iafilius/CarElectricalRadiatorFanController/pictures/IMG_4896.JPG

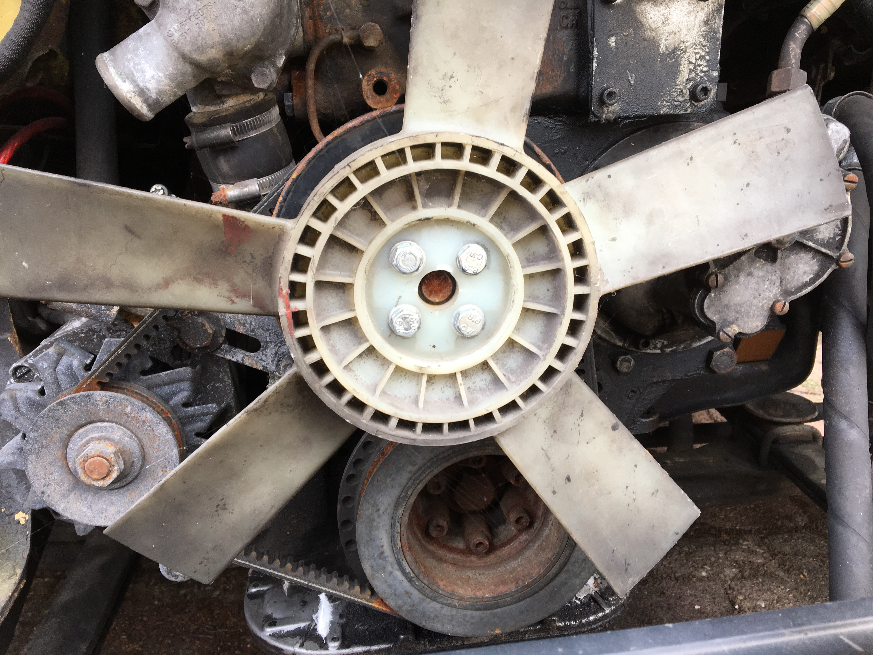
pictures/IMG_4896.JPG
