iafilius/CarElectricalRadiatorFanController/pictures/IMG_5004.JPG

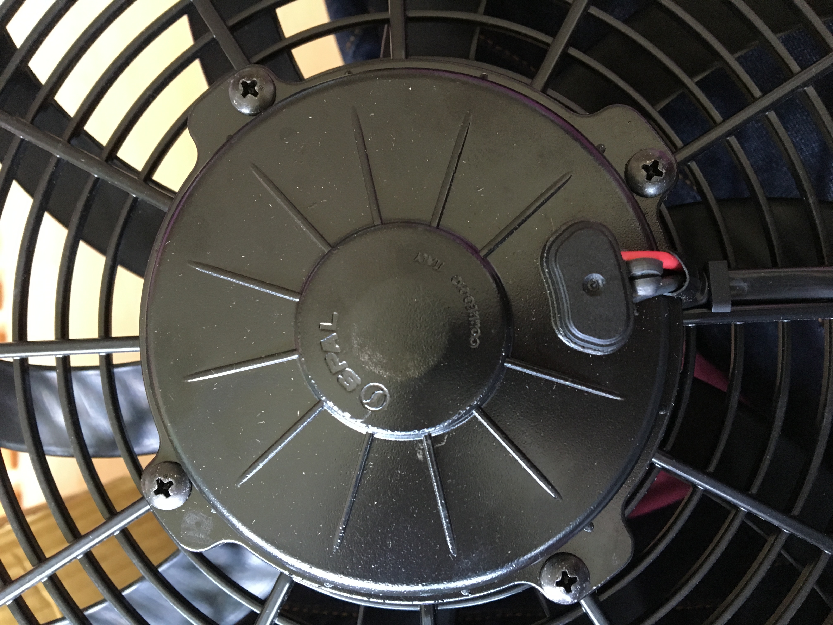
pictures/IMG_5004.JPG
