iafilius/CarElectricalRadiatorFanController/pictures/IMG_5005.JPG

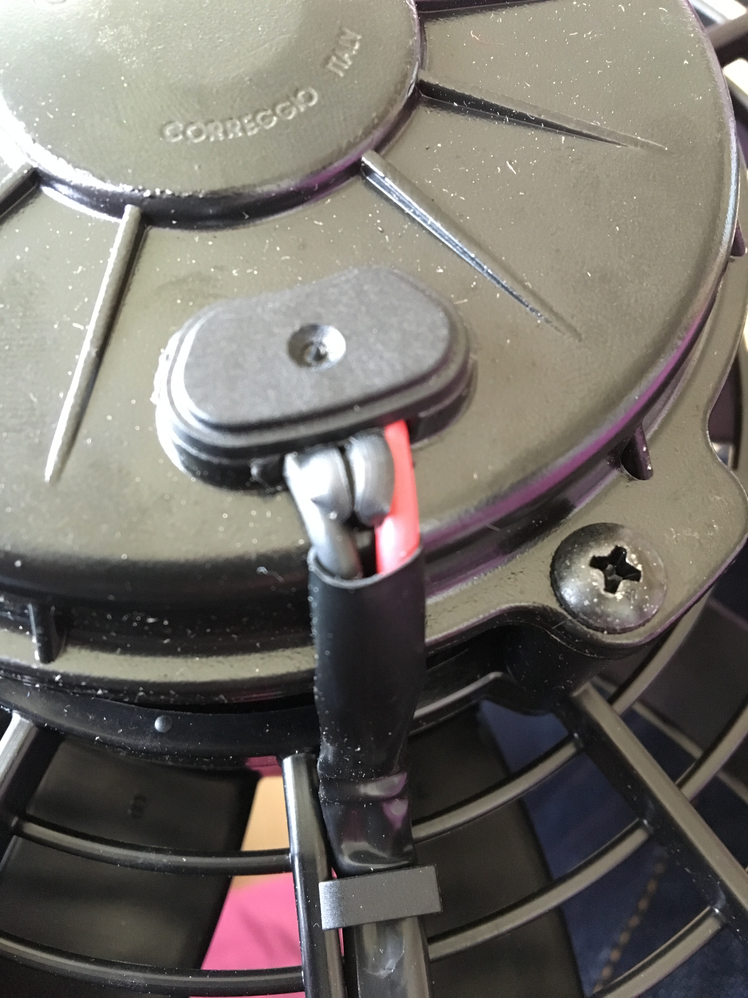
pictures/IMG_5005.JPG
