iafilius/CarElectricalRadiatorFanController/pictures/IMG_5008.JPG

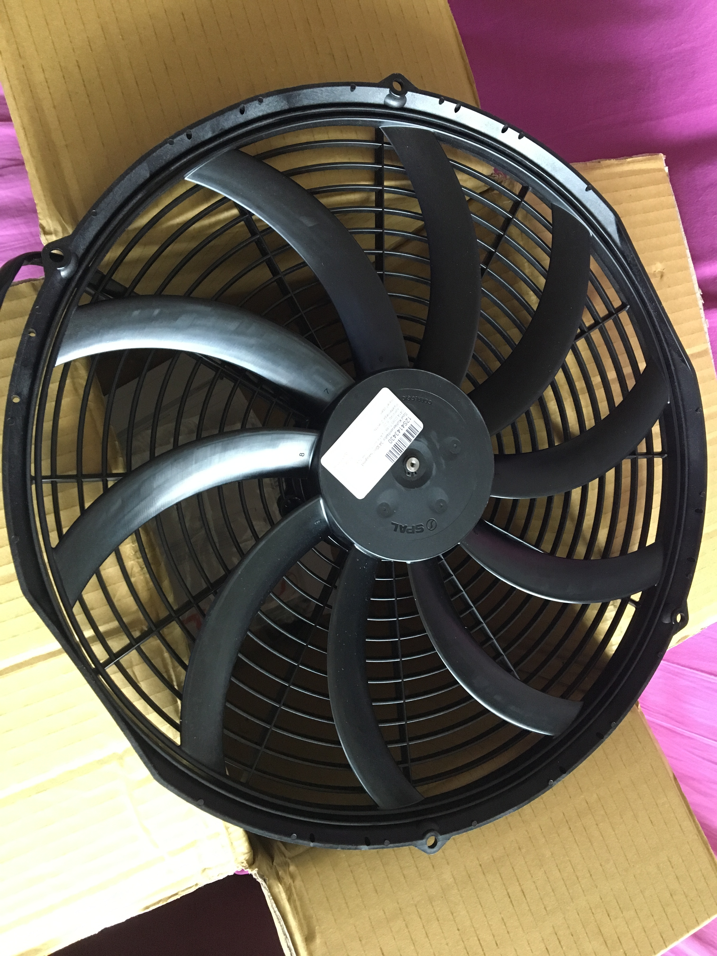
pictures/IMG_5008.JPG
