iafilius/CarElectricalRadiatorFanController/pictures/IMG_5502.JPG

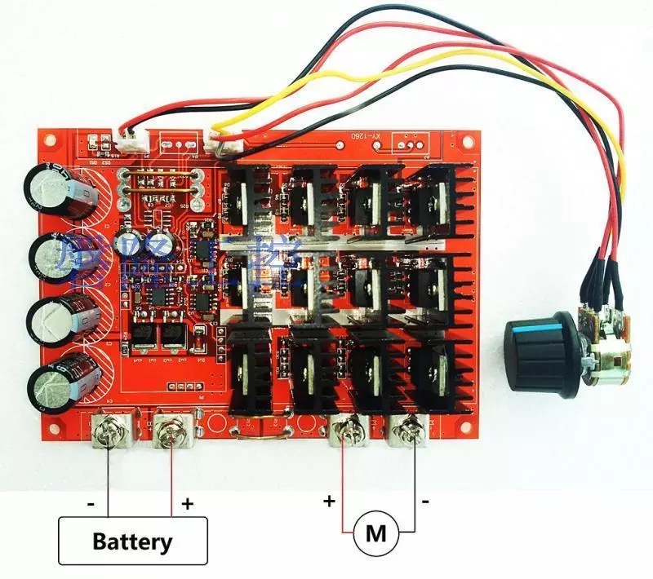
pictures/IMG_5502.JPG
