iafilius/CarElectricalRadiatorFanController/pictures/IMG_5505 - Copy.JPG

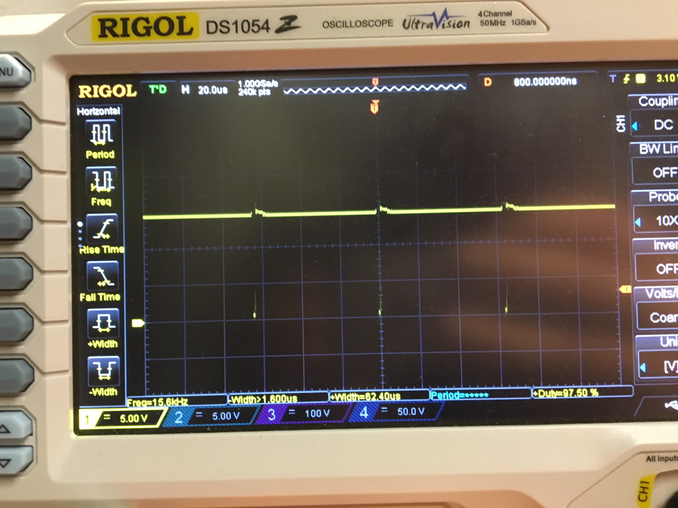
pictures/IMG_5505 - Copy.JPG
