iafilius/CarElectricalRadiatorFanController/pictures/IMG_5506 - Copy.JPG

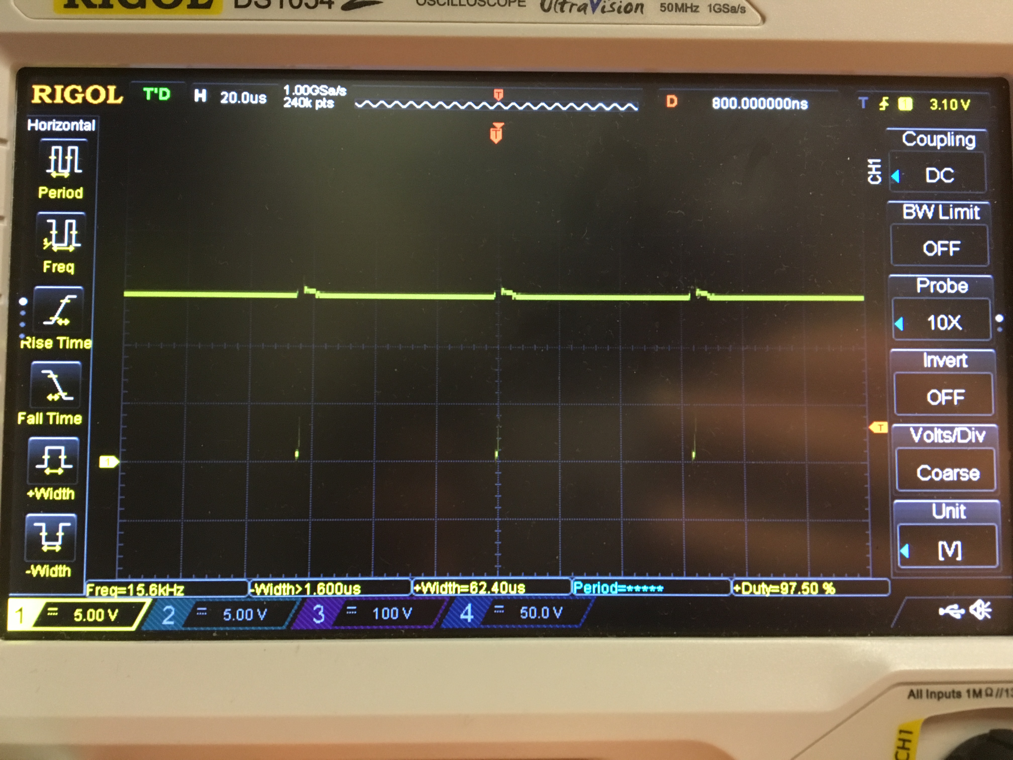
pictures/IMG_5506 - Copy.JPG
