iafilius/CarElectricalRadiatorFanController/pictures/IMG_5507 - Copy.JPG

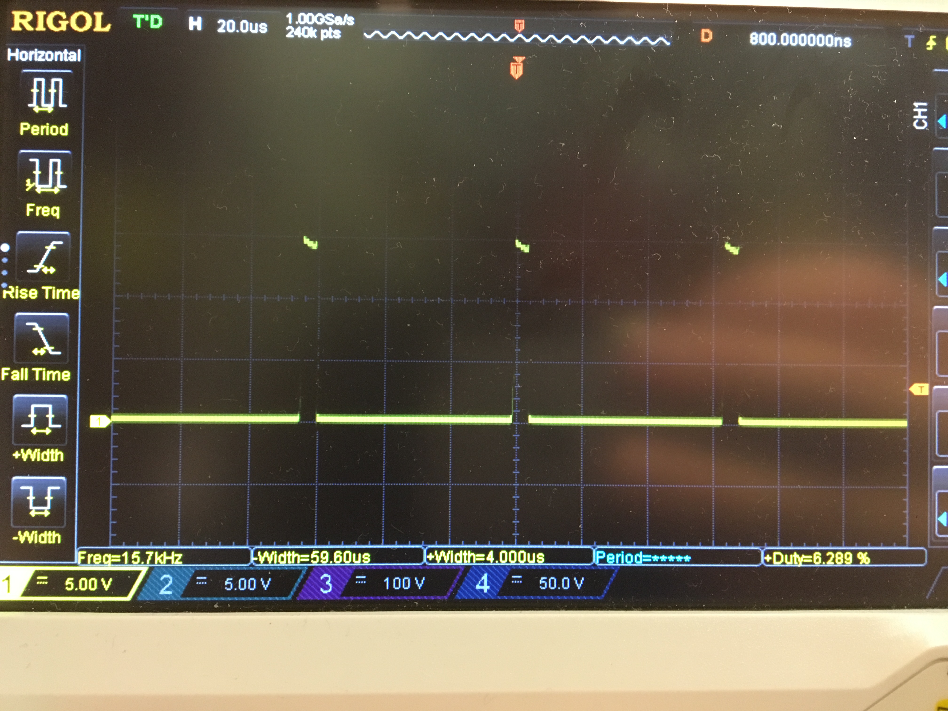
pictures/IMG_5507 - Copy.JPG
