iafilius/CarElectricalRadiatorFanController/pictures/IMG_5509 - Copy.JPG

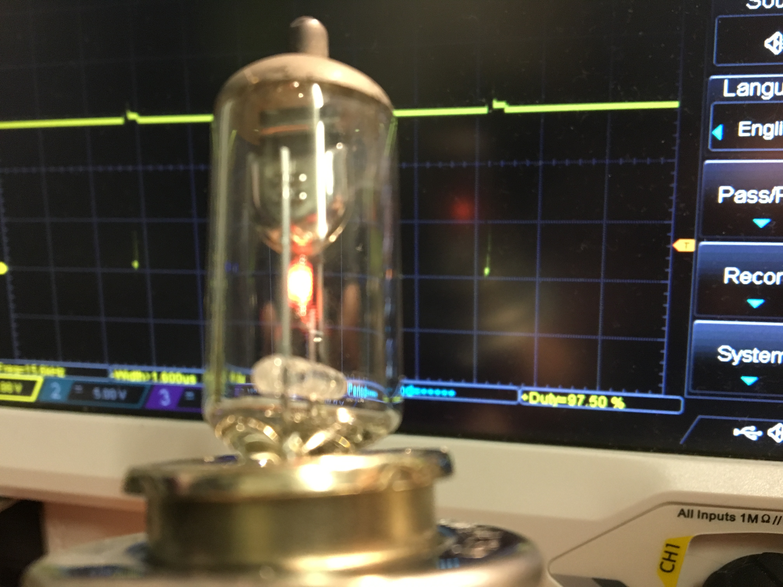
pictures/IMG_5509 - Copy.JPG
