iafilius/CarElectricalRadiatorFanController/pictures/IMG_5516.JPG

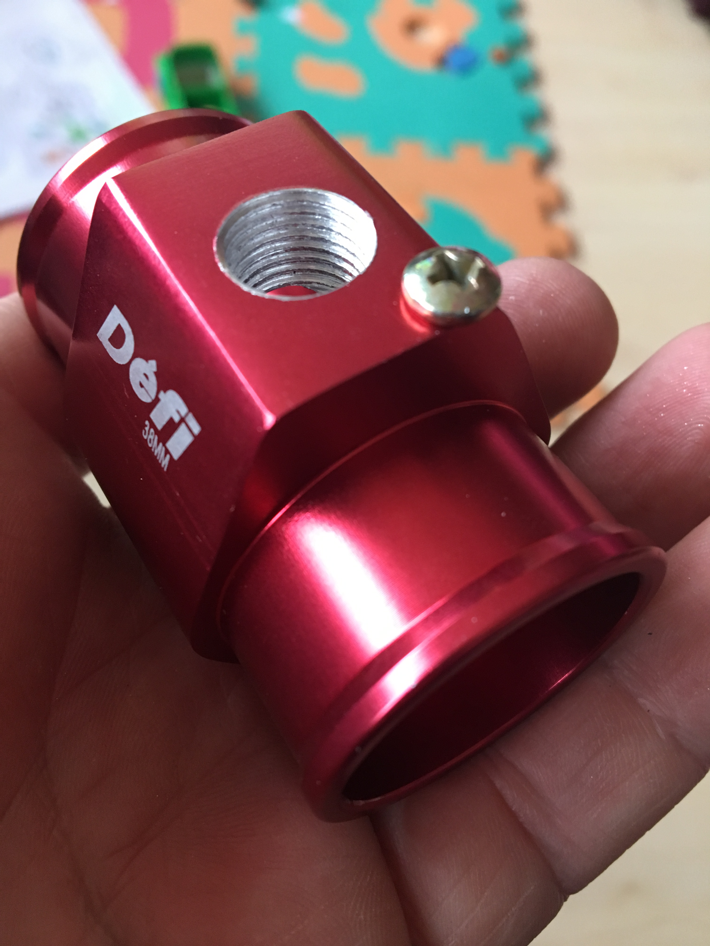
pictures/IMG_5516.JPG
