iafilius/CarElectricalRadiatorFanController/pictures/IMG_5518.JPG

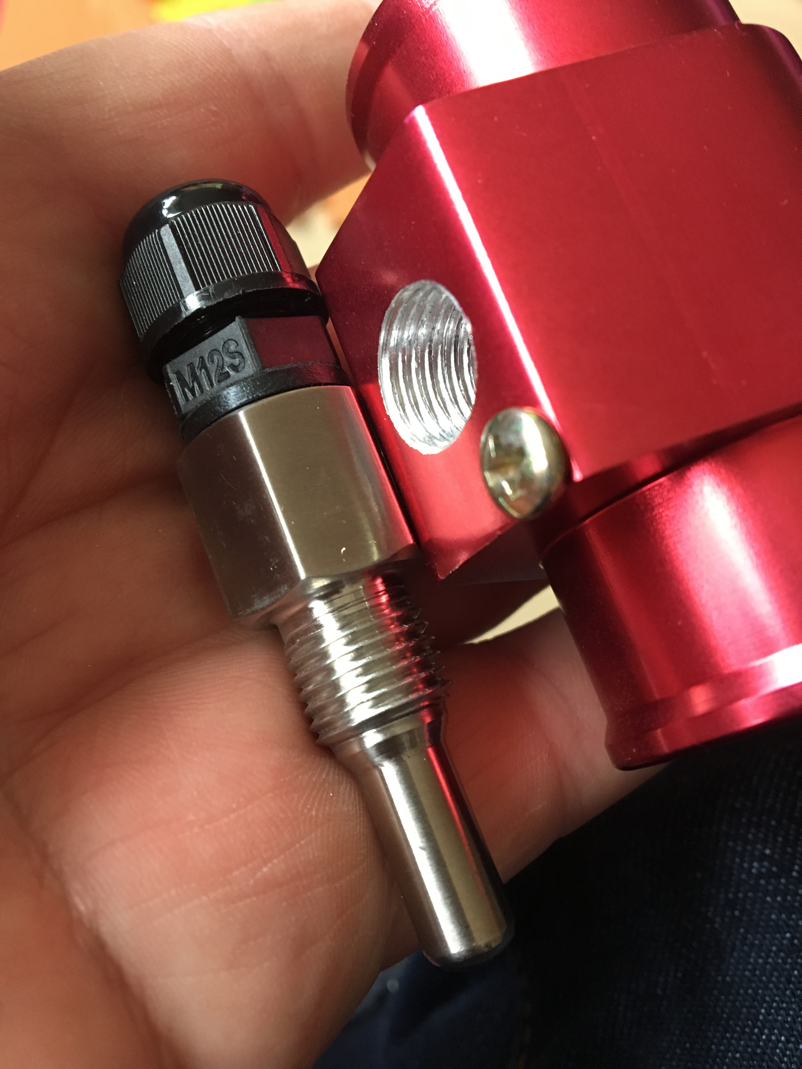
pictures/IMG_5518.JPG
