iafilius/CarElectricalRadiatorFanController/pictures/IMG_5519.JPG

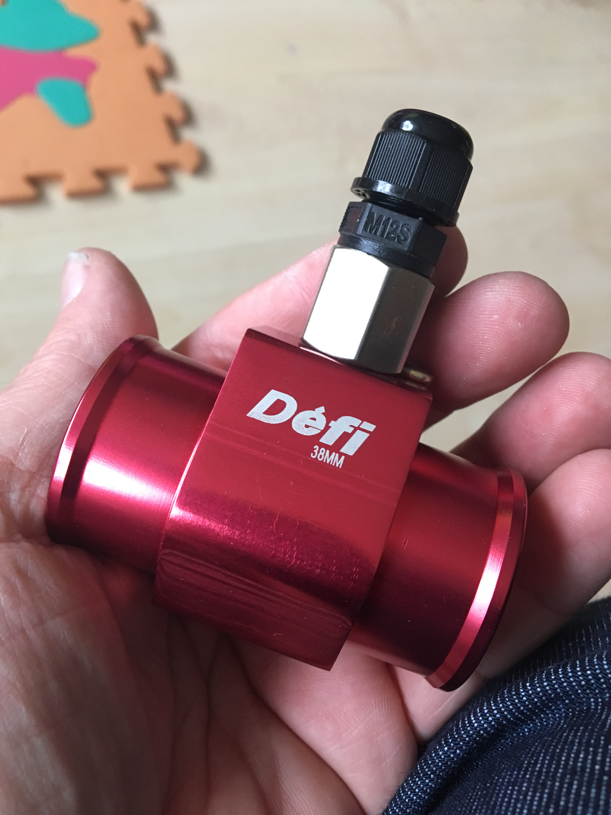
pictures/IMG_5519.JPG
