iafilius/CarElectricalRadiatorFanController/pictures/IMG_5520.JPG

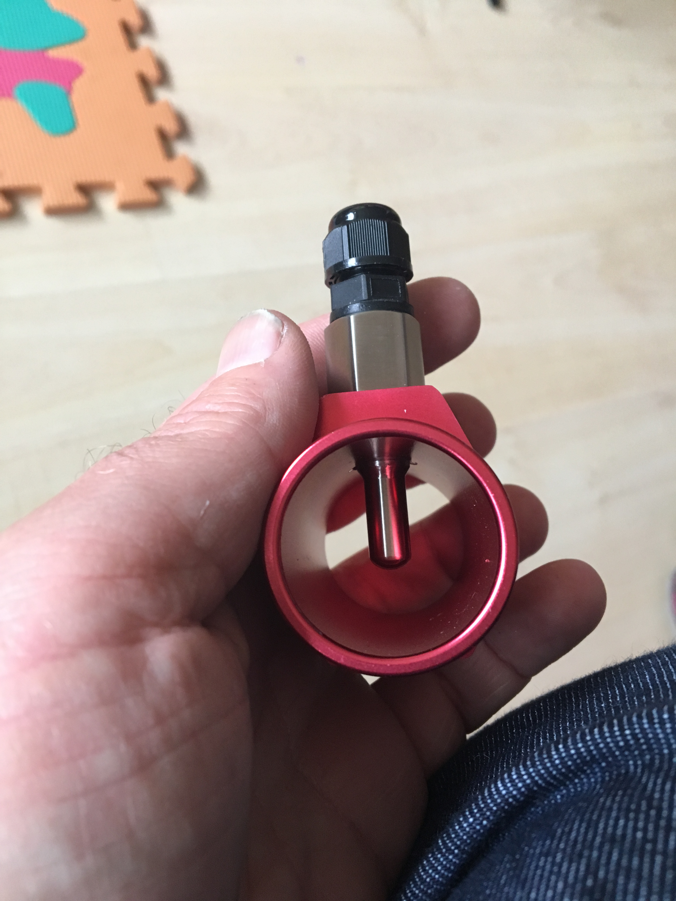
pictures/IMG_5520.JPG
