iafilius/CarElectricalRadiatorFanController/pictures/IMG_5521.JPG

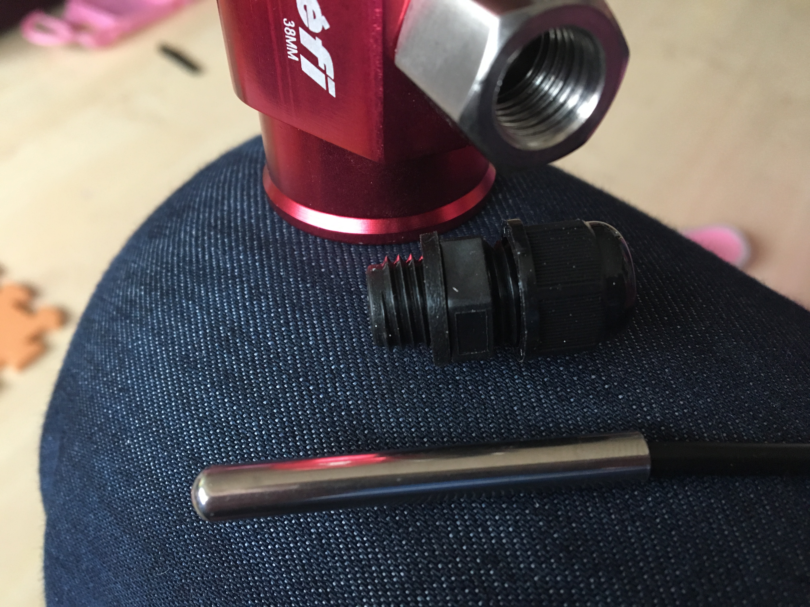
pictures/IMG_5521.JPG
