iafilius/CarElectricalRadiatorFanController/pictures/IMG_5522.JPG

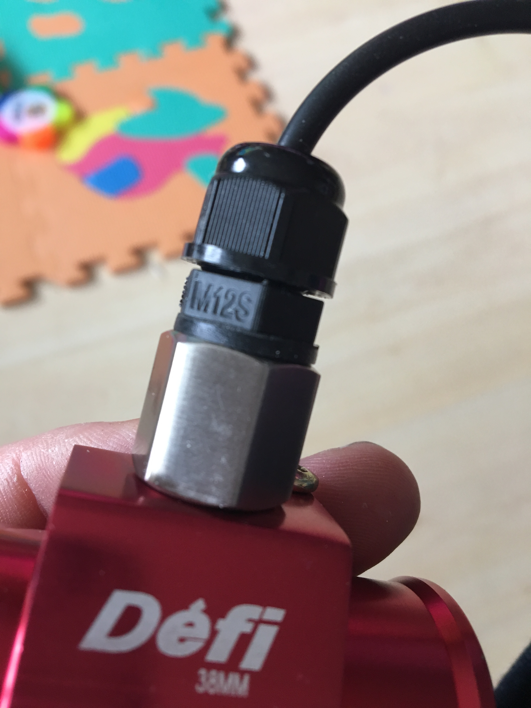
pictures/IMG_5522.JPG
