iafilius/CarElectricalRadiatorFanController/pictures/IMG_5523.JPG

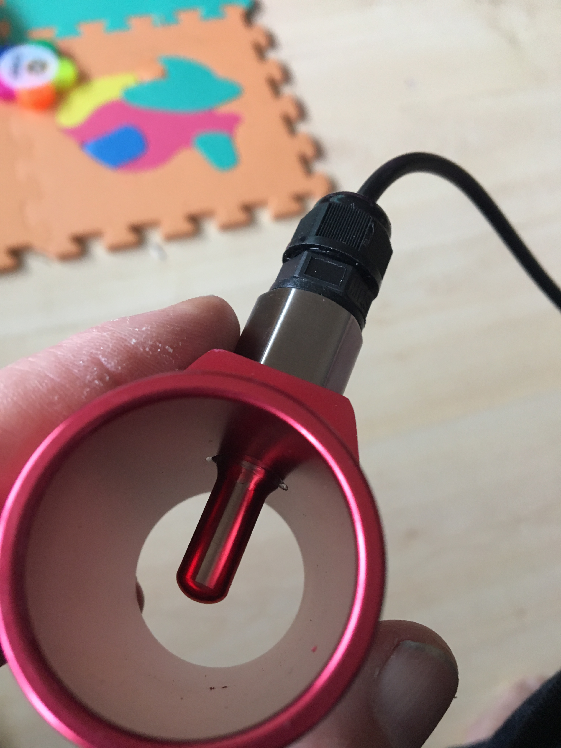
pictures/IMG_5523.JPG
