iafilius/CarElectricalRadiatorFanController/pictures/IMG_5721.JPG

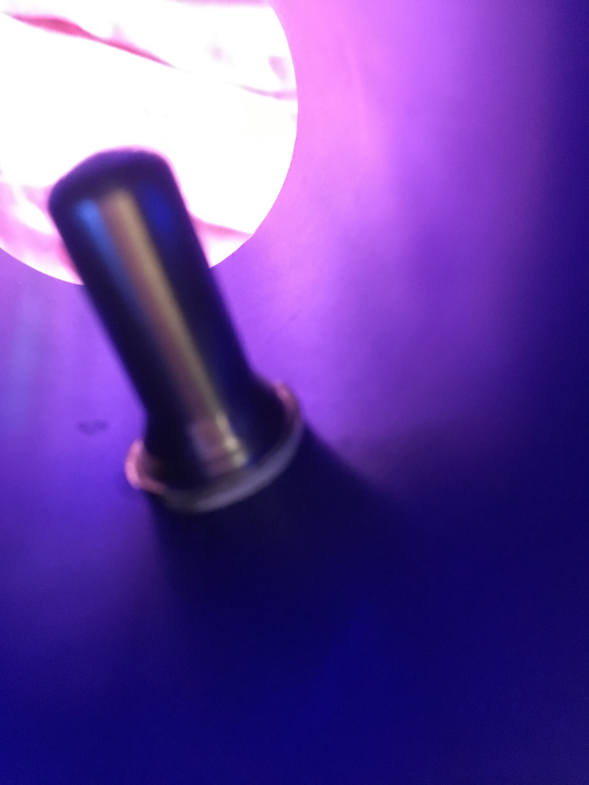
pictures/IMG_5721.JPG
