iafilius/CarElectricalRadiatorFanController/pictures/IMG_5722.JPG

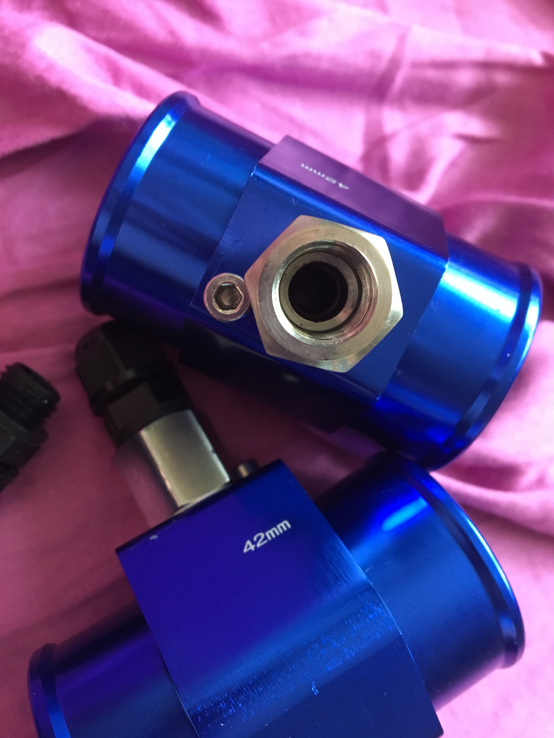
pictures/IMG_5722.JPG
