iafilius/CarElectricalRadiatorFanController/pictures/IMG_5723.JPG

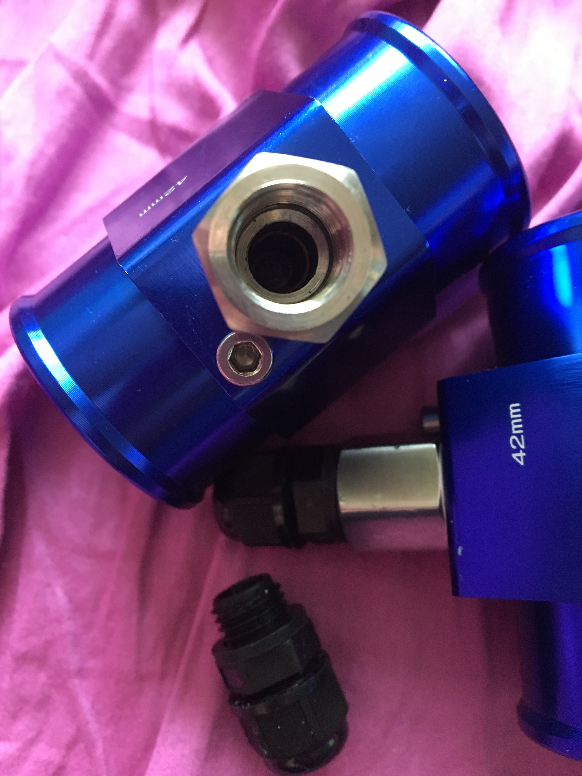
pictures/IMG_5723.JPG
