iafilius/CarElectricalRadiatorFanController/pictures/IMG_5724.JPG

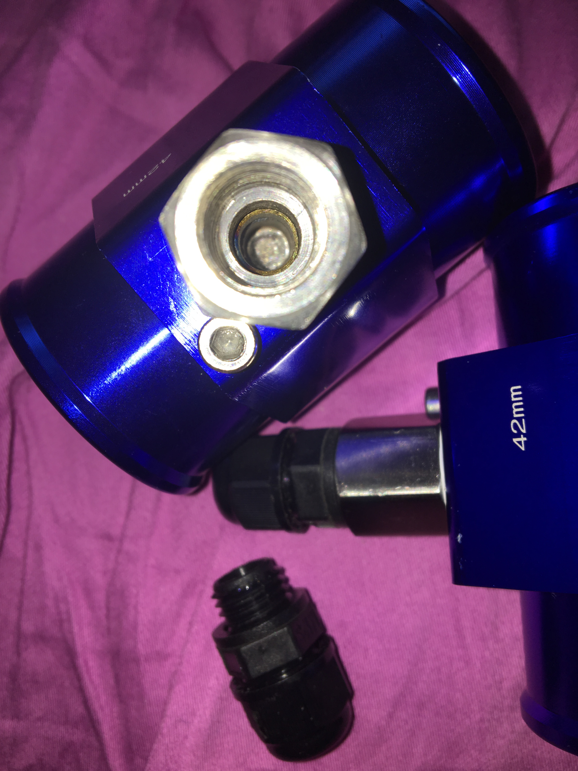
pictures/IMG_5724.JPG
