iafilius/CarElectricalRadiatorFanController/pictures/IMG_5725.JPG

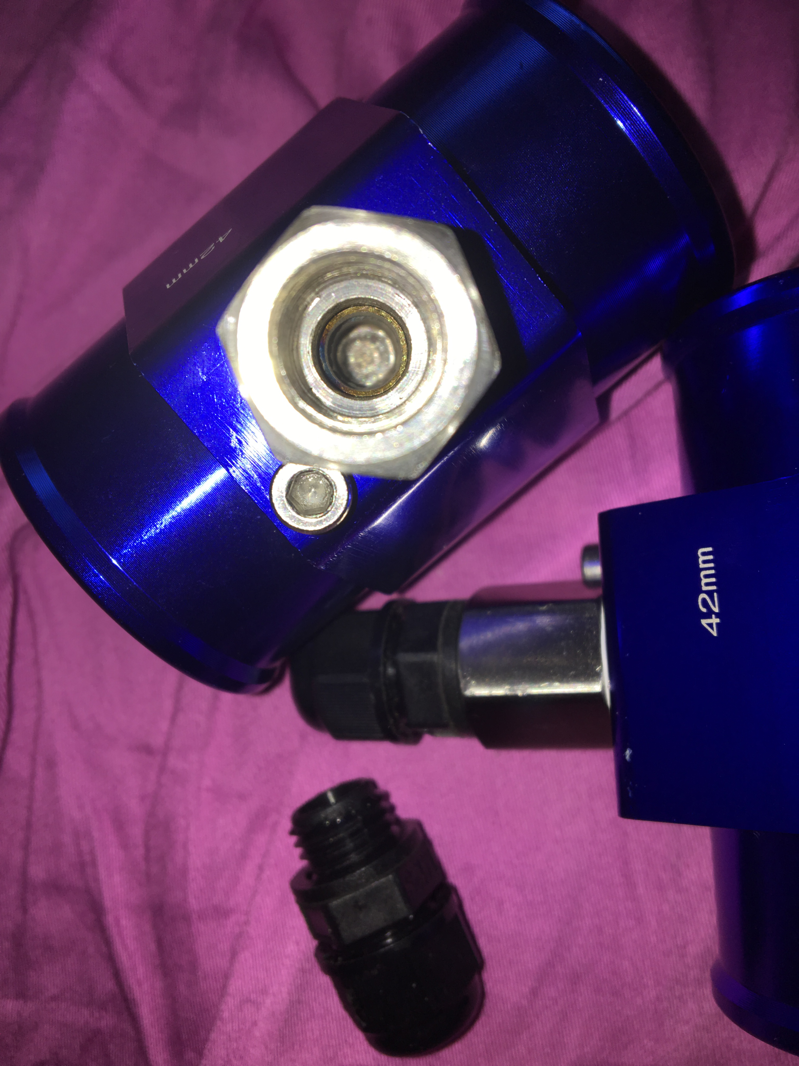
pictures/IMG_5725.JPG
