iafilius/CarElectricalRadiatorFanController/pictures/IMG_5726.JPG

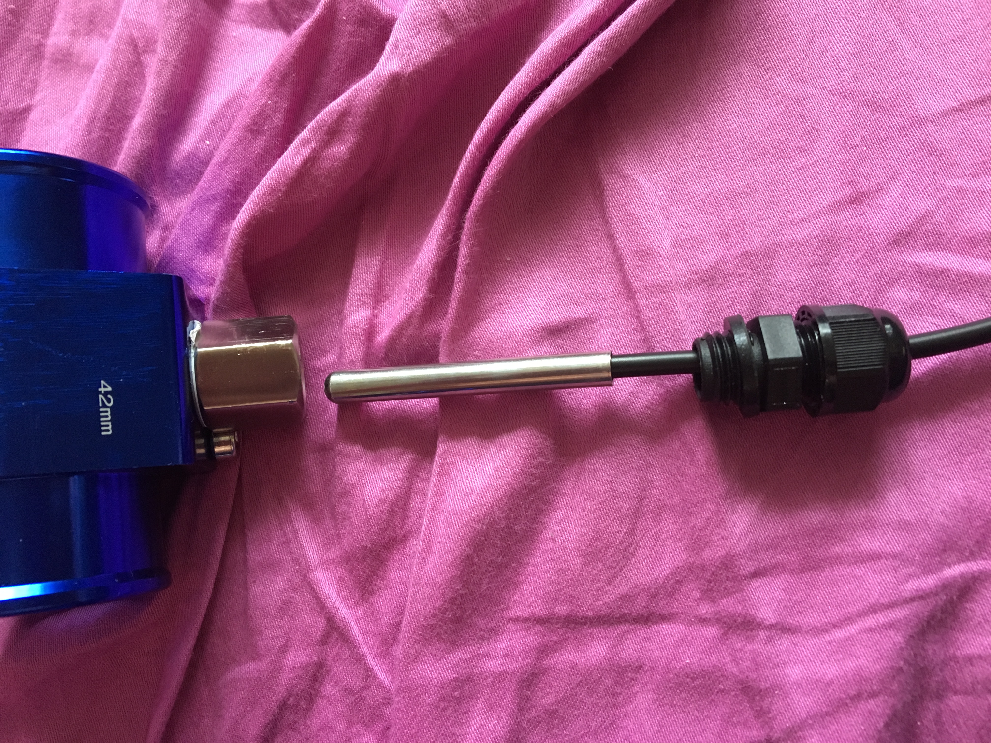
pictures/IMG_5726.JPG
