iafilius/CarElectricalRadiatorFanController/pictures/IMG_5727.JPG

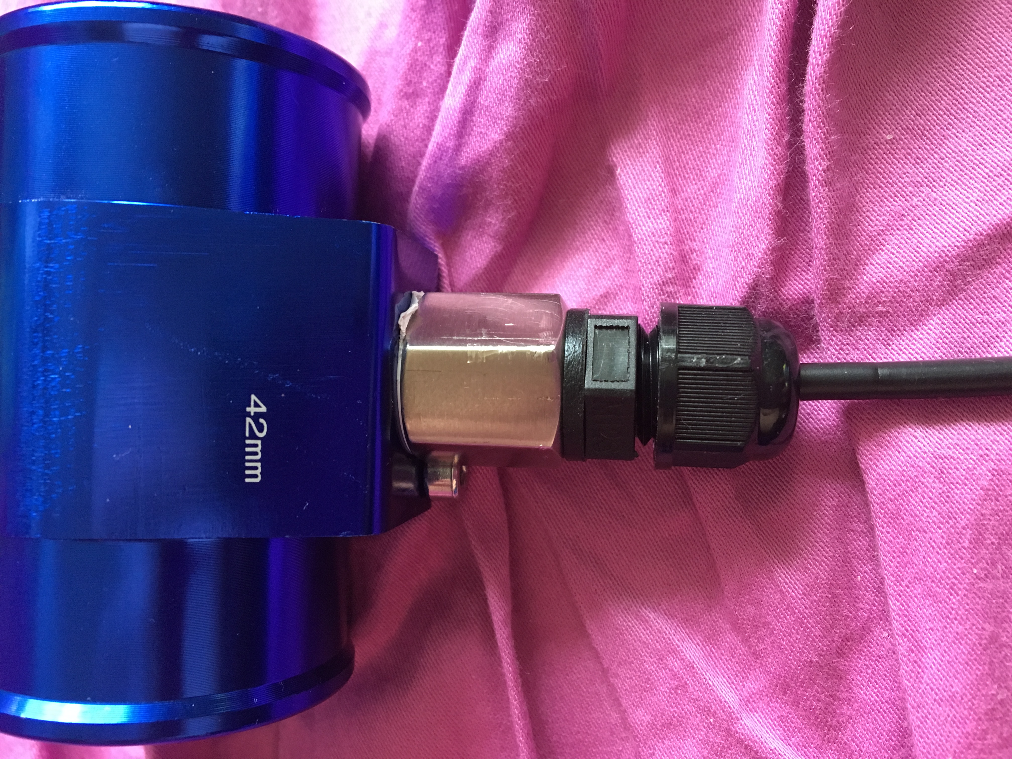
pictures/IMG_5727.JPG
