iafilius/CarElectricalRadiatorFanController/pictures/IMG_5729.JPG

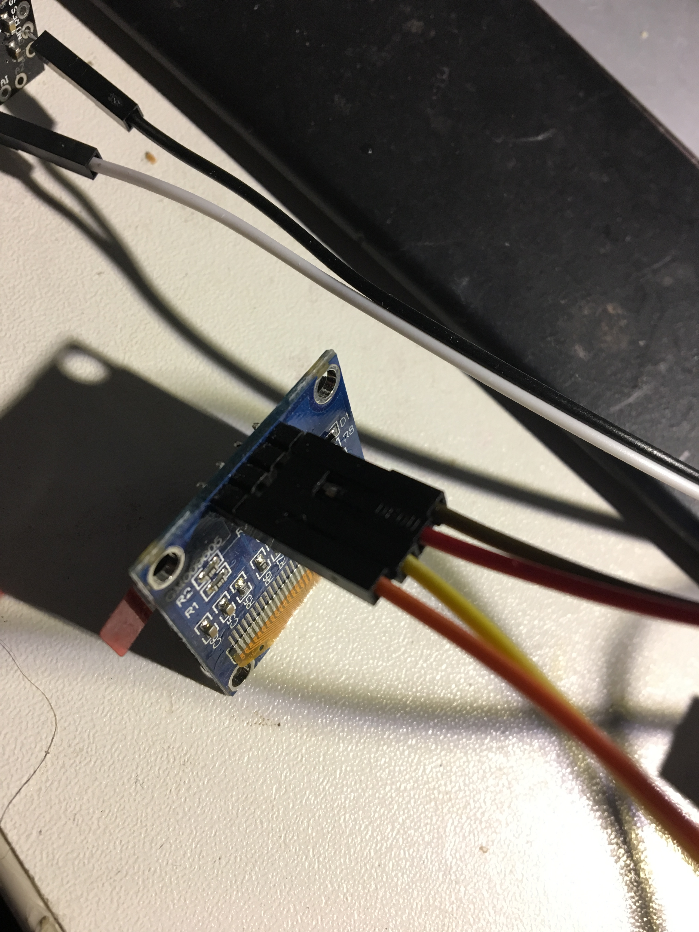
pictures/IMG_5729.JPG
