iafilius/CarElectricalRadiatorFanController/pictures/IMG_8650.JPG

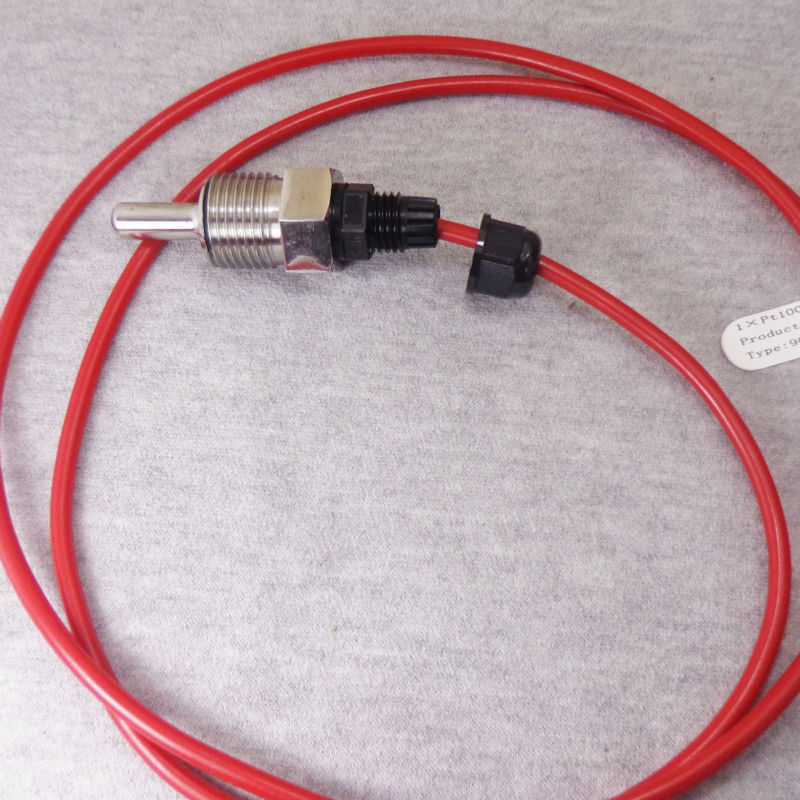
pictures/IMG_8650.JPG
