iafilius/CarElectricalRadiatorFanController/pictures/IMG_8731.JPG

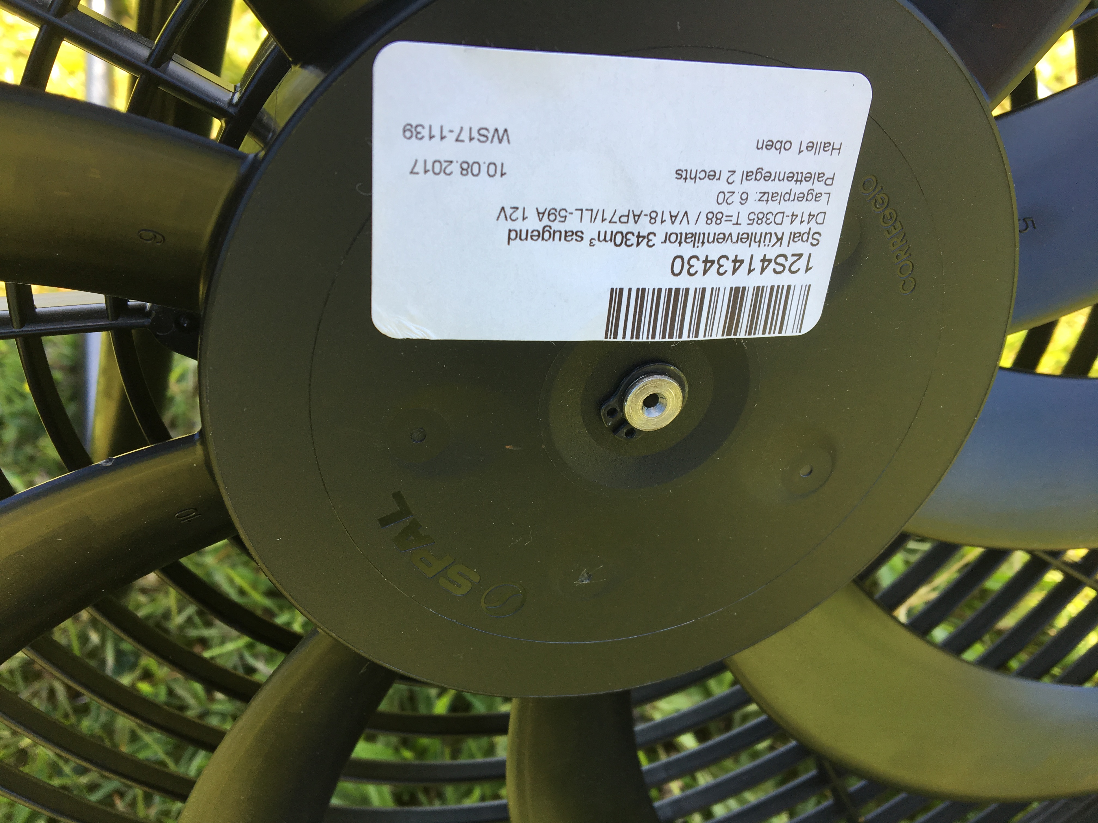
pictures/IMG_8731.JPG
