iafilius/CarElectricalRadiatorFanController/pictures/IMG_8733.JPG

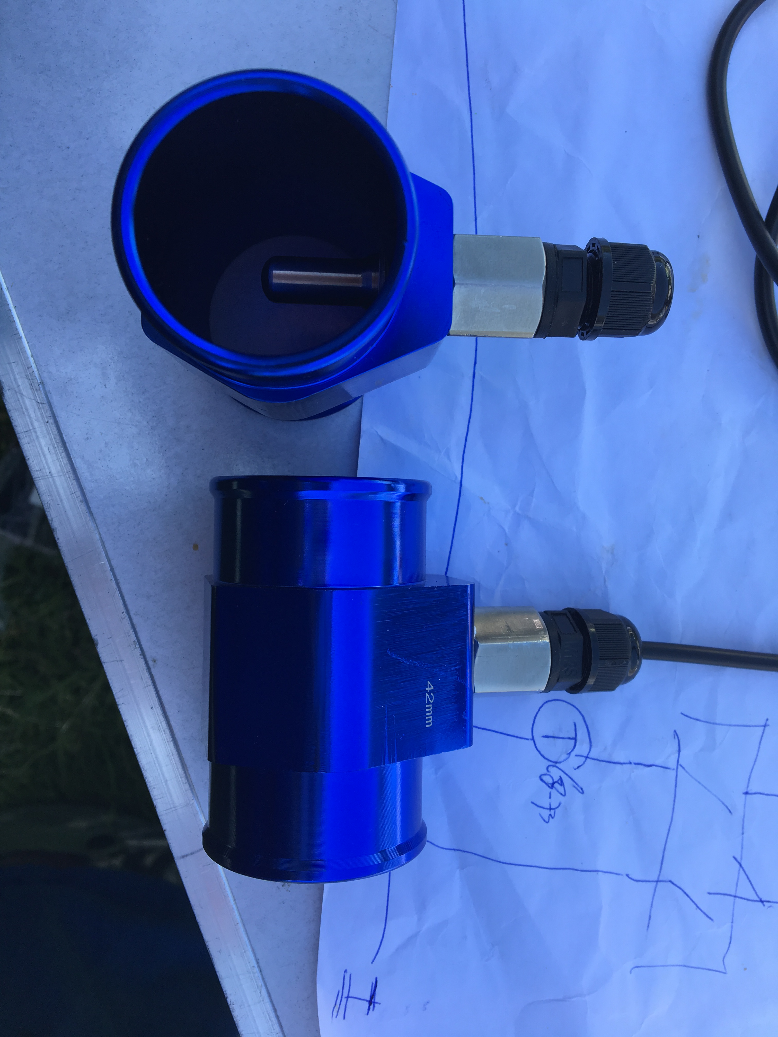
pictures/IMG_8733.JPG
