iafilius/CarElectricalRadiatorFanController/pictures/IMG_8734.JPG

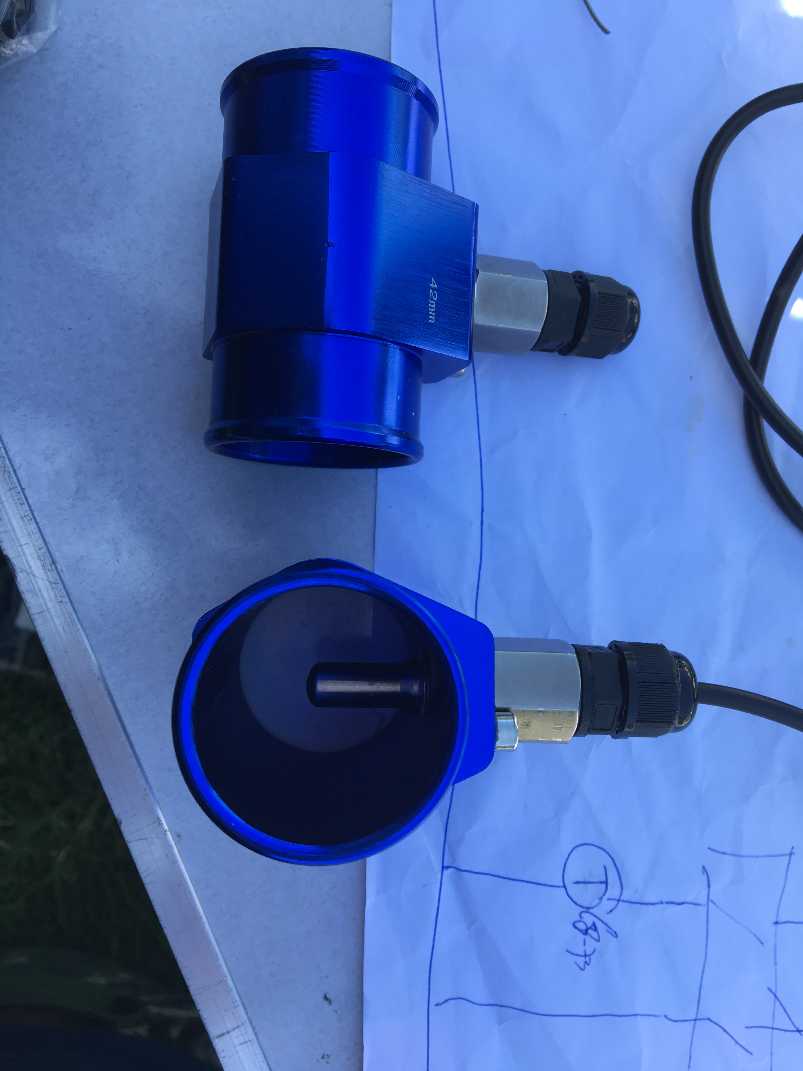
pictures/IMG_8734.JPG
