iafilius/CarElectricalRadiatorFanController/pictures/IMG_8735.JPG

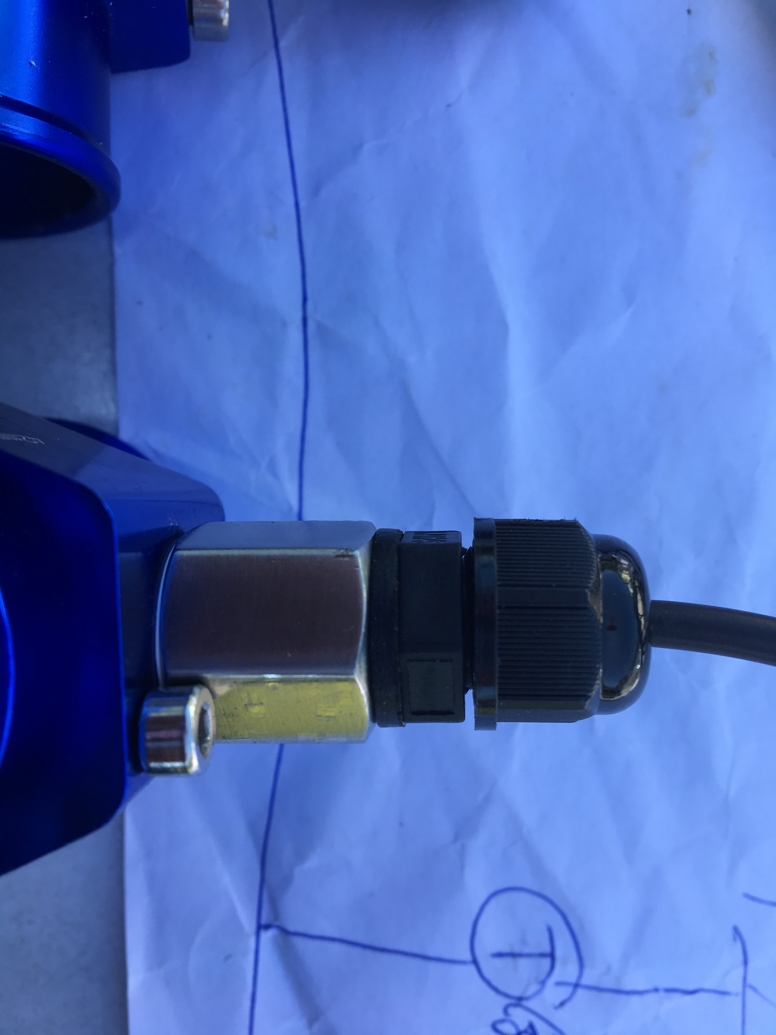
pictures/IMG_8735.JPG
