iafilius/CarElectricalRadiatorFanController/pictures/IMG_8736.JPG

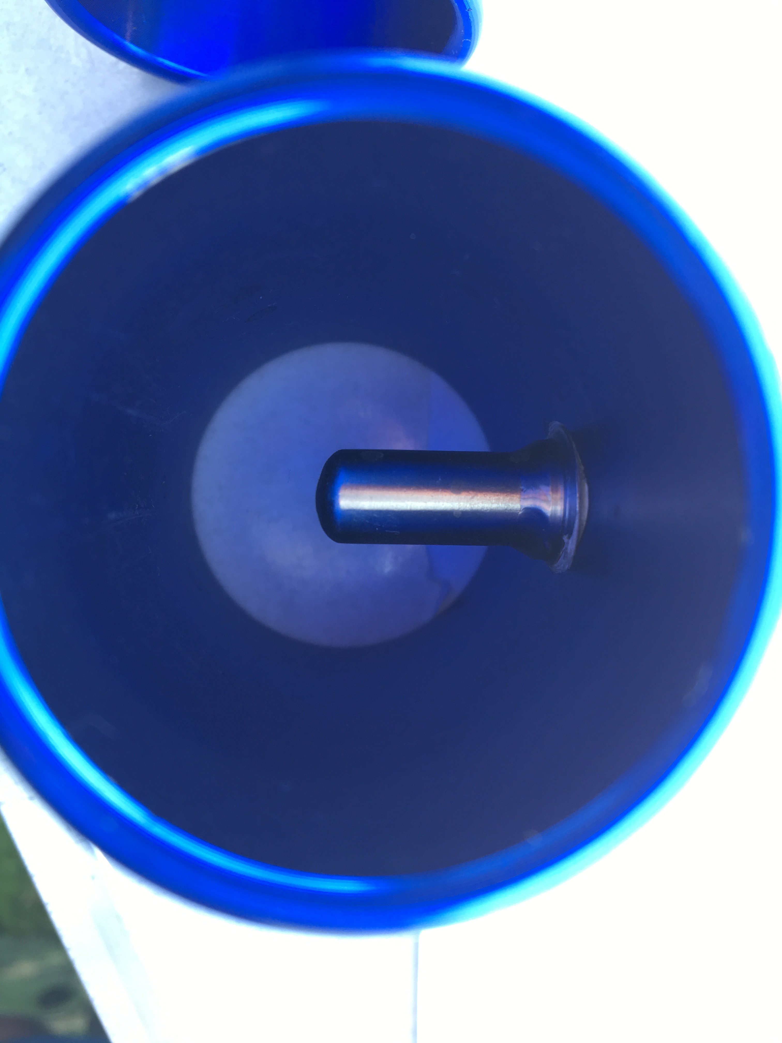
pictures/IMG_8736.JPG
