iafilius/CarElectricalRadiatorFanController/pictures/IMG_8737.JPG

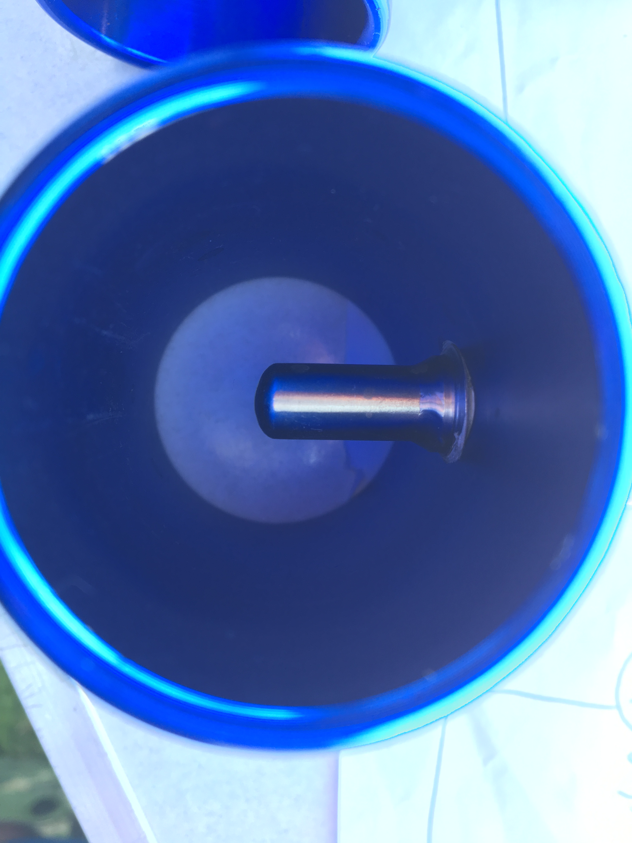
pictures/IMG_8737.JPG
