iafilius/CarElectricalRadiatorFanController/pictures/IMG_8739.JPG

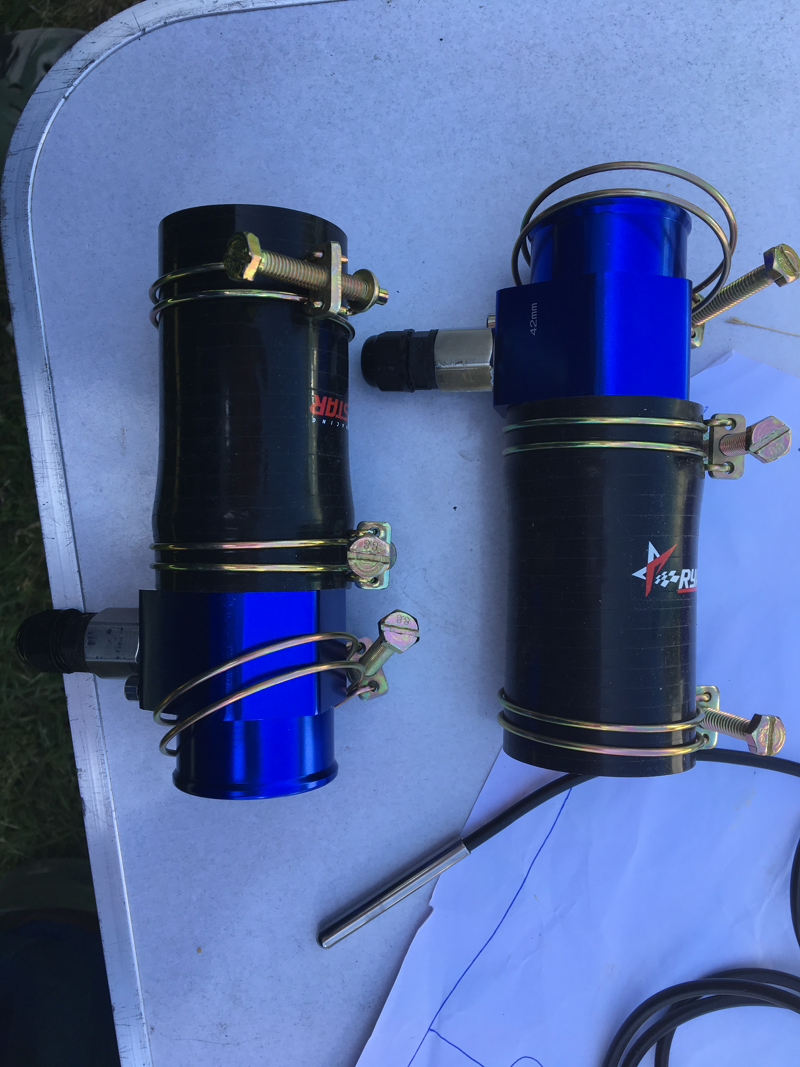
pictures/IMG_8739.JPG
