iafilius/CarElectricalRadiatorFanController/pictures/IMG_8751.JPG

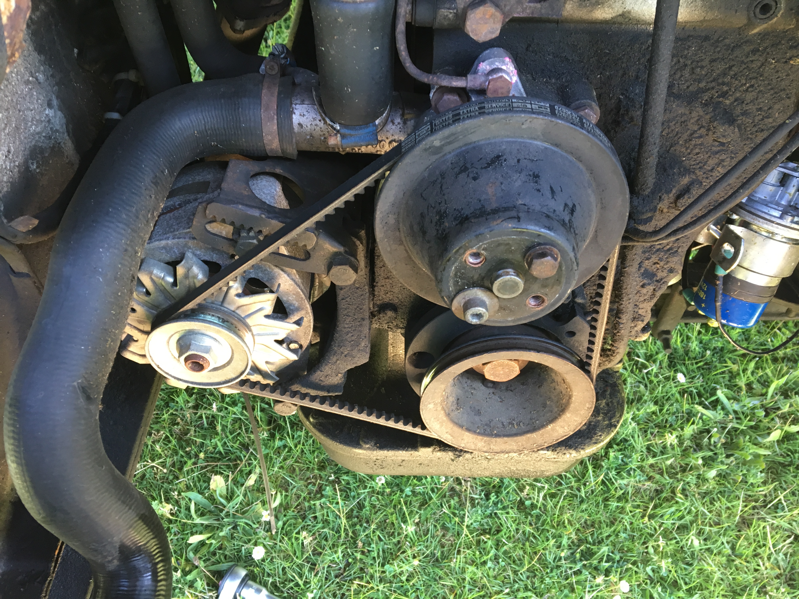
pictures/IMG_8751.JPG
