iafilius/CarElectricalRadiatorFanController/pictures/IMG_8752.JPG

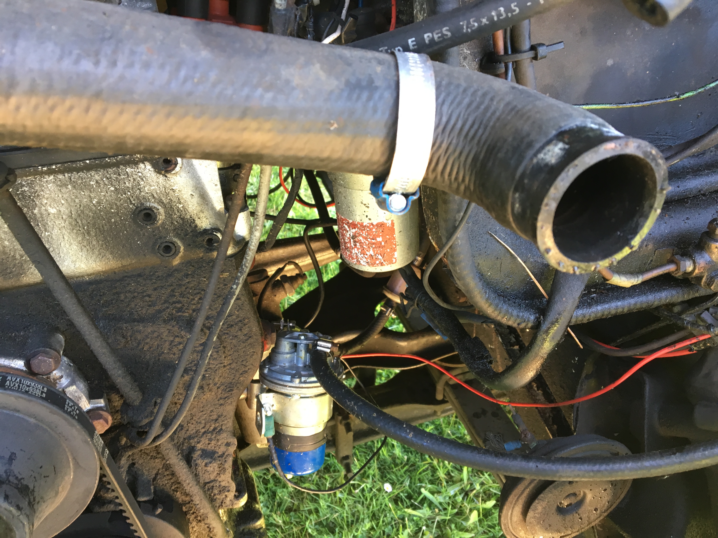
pictures/IMG_8752.JPG
