iafilius/CarElectricalRadiatorFanController/pictures/IMG_8753.JPG

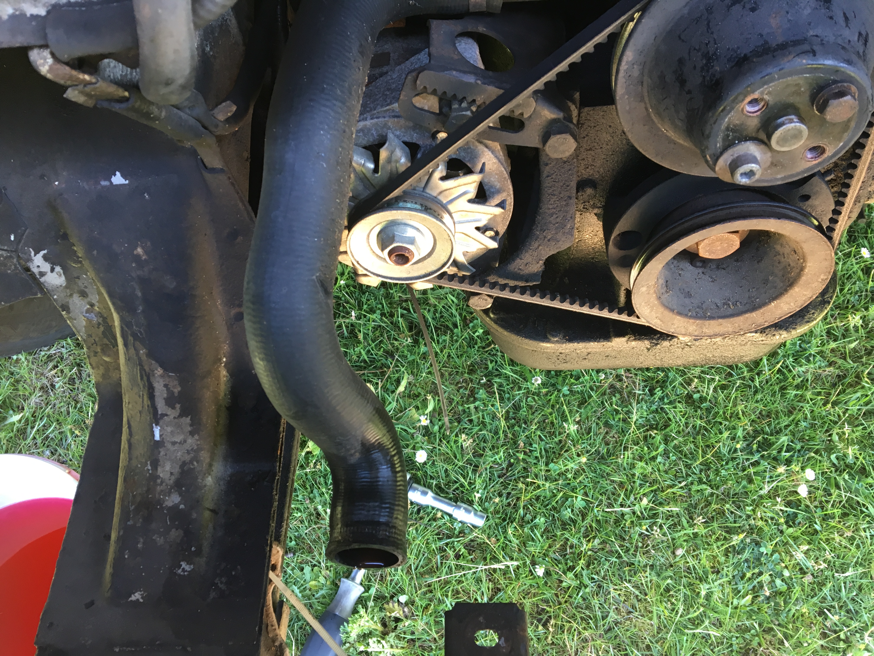
pictures/IMG_8753.JPG
