iafilius/CarElectricalRadiatorFanController/pictures/IMG_8754.JPG

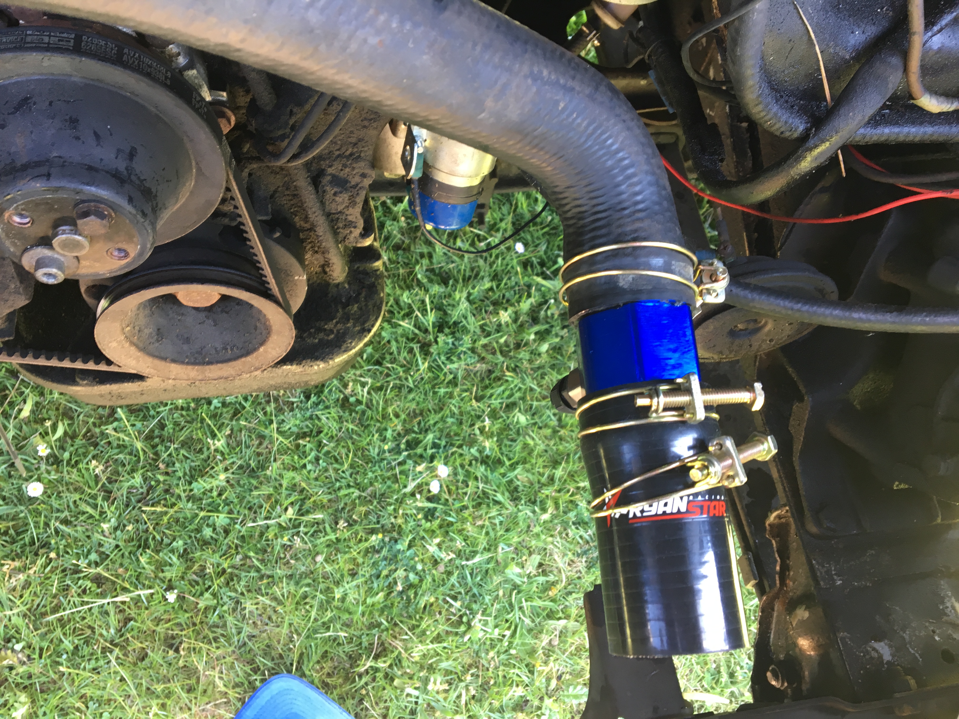
pictures/IMG_8754.JPG
