iafilius/CarElectricalRadiatorFanController/pictures/IMG_8755.JPG

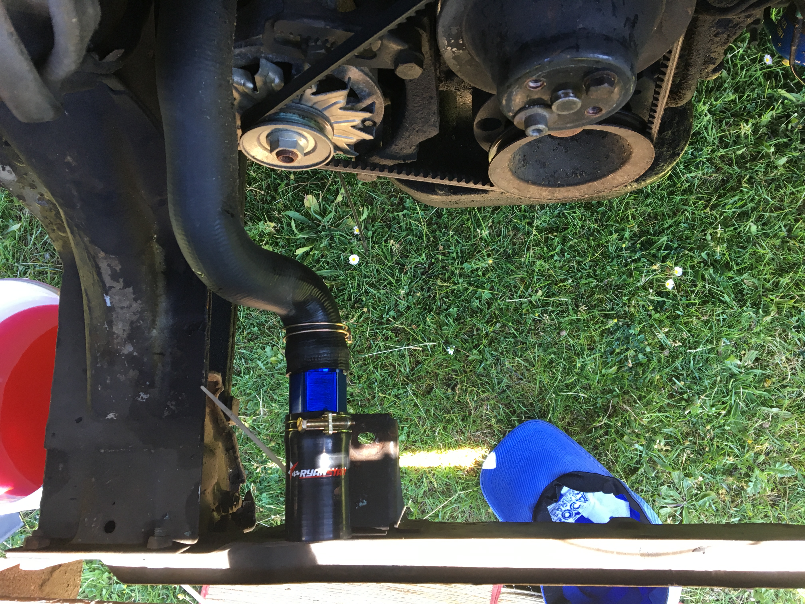
pictures/IMG_8755.JPG
