iafilius/CarElectricalRadiatorFanController/pictures/IMG_8756.JPG

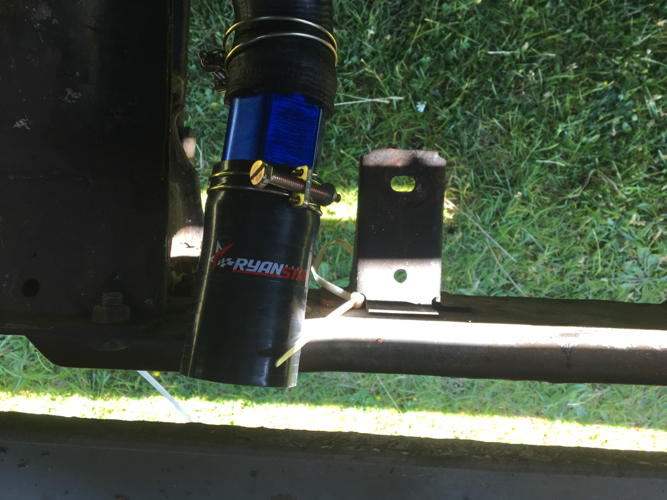
pictures/IMG_8756.JPG
