iafilius/CarElectricalRadiatorFanController/pictures/IMG_8757.JPG

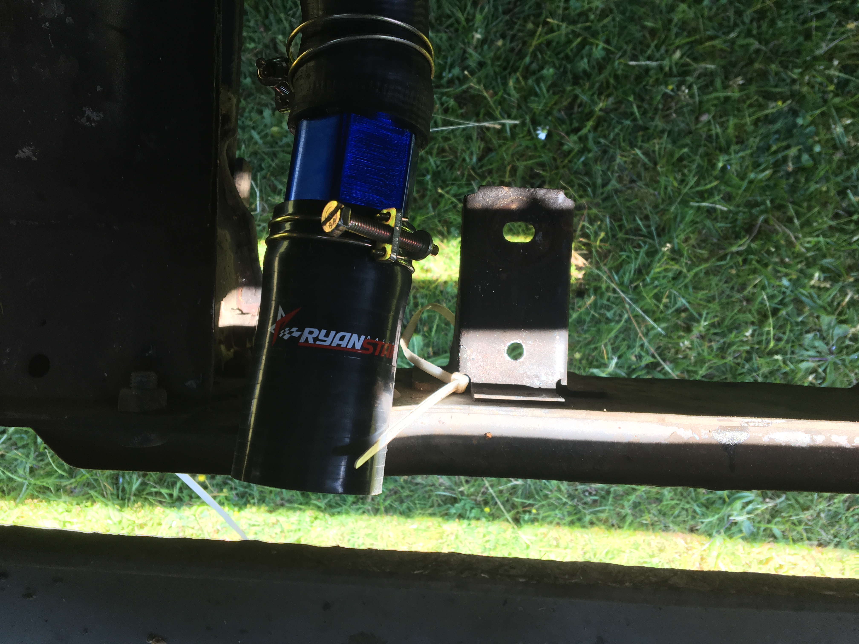
pictures/IMG_8757.JPG
