iafilius/CarElectricalRadiatorFanController/pictures/IMG_8760.JPG

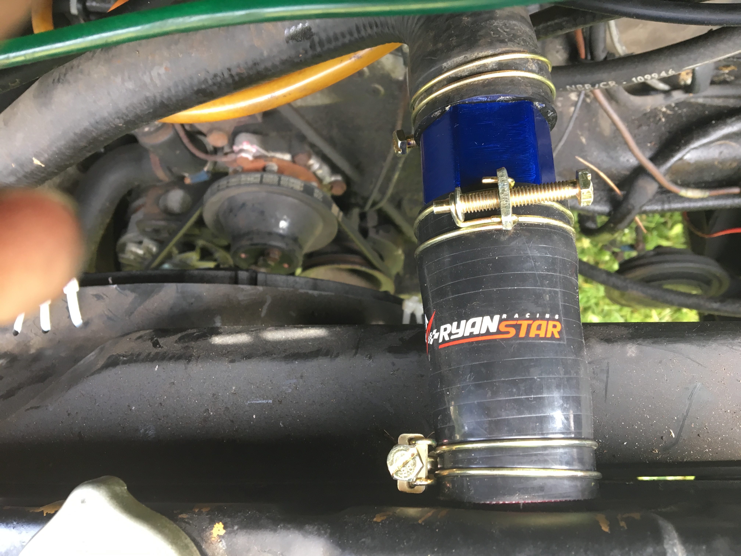
pictures/IMG_8760.JPG
