iafilius/CarElectricalRadiatorFanController/pictures/IMG_8761.JPG

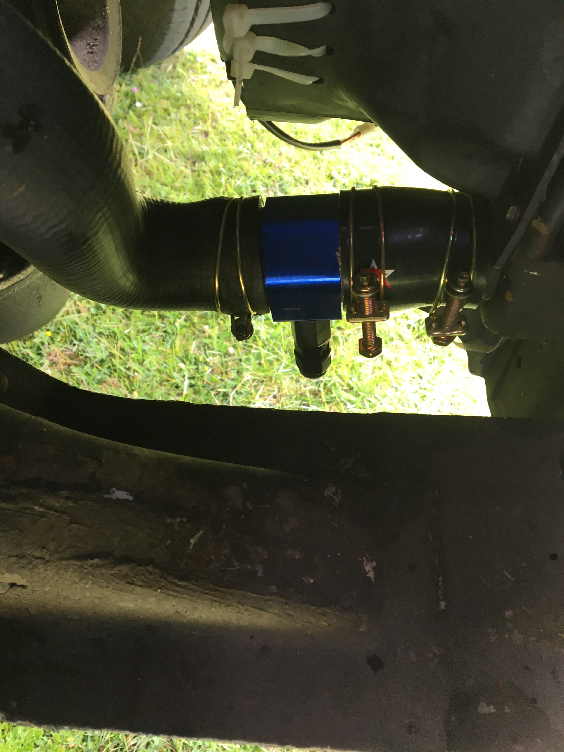
pictures/IMG_8761.JPG
