iafilius/CarElectricalRadiatorFanController/pictures/IMG_8762.JPG

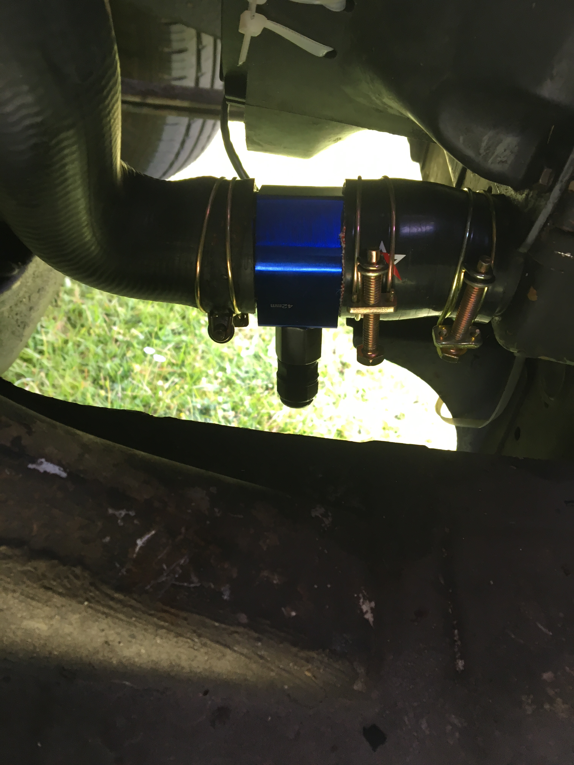
pictures/IMG_8762.JPG
