iafilius/CarElectricalRadiatorFanController/pictures/IMG_8763.JPG

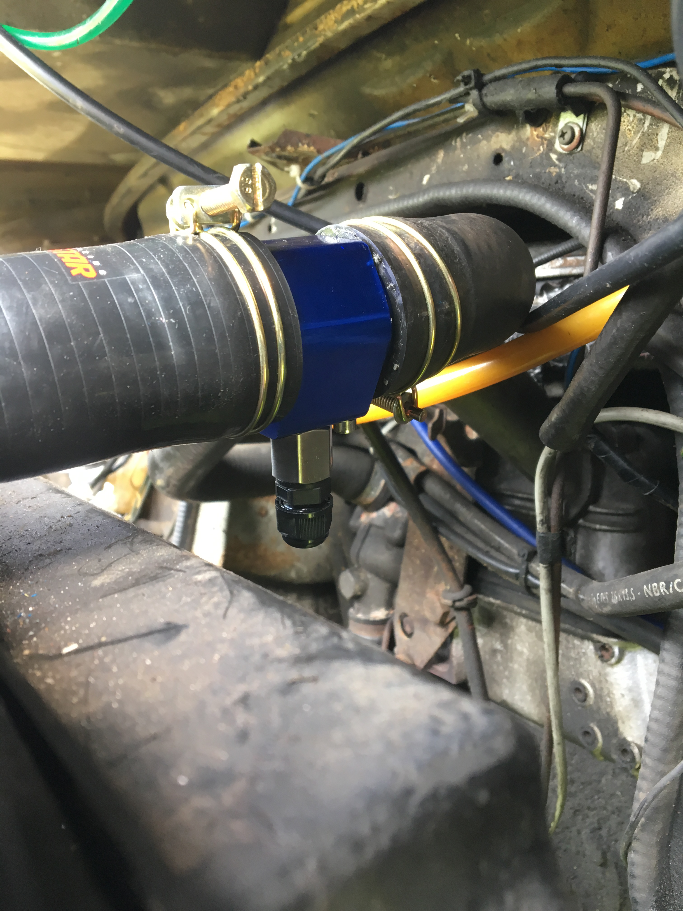
pictures/IMG_8763.JPG
