iafilius/CarElectricalRadiatorFanController/pictures/IMG_8764.JPG

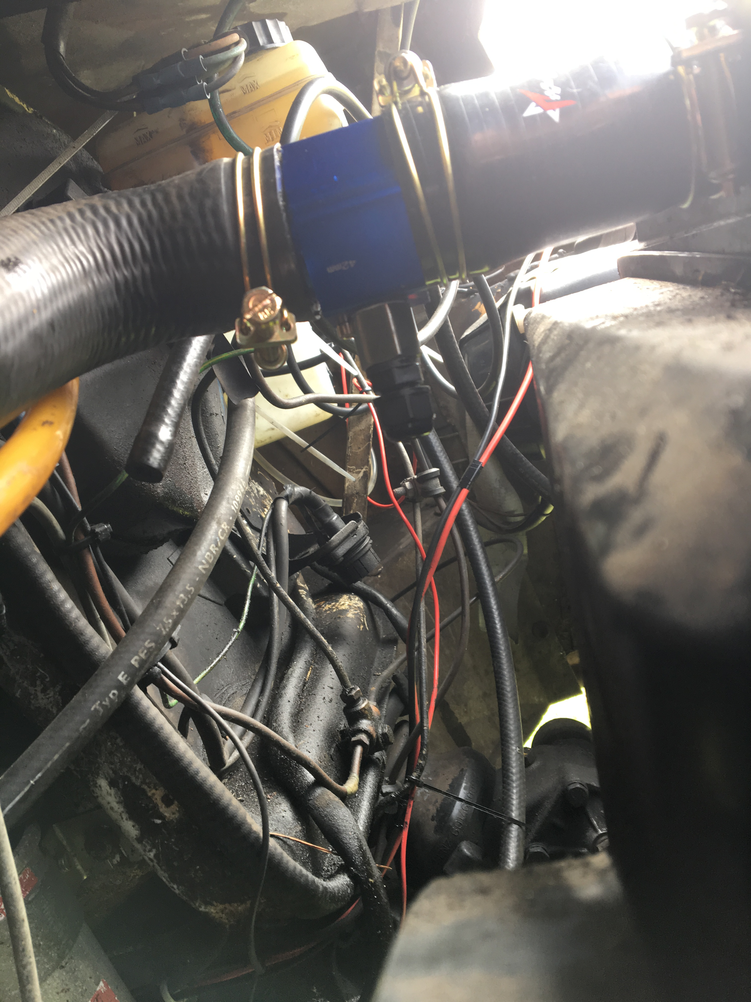
pictures/IMG_8764.JPG
