iafilius/CarElectricalRadiatorFanController/pictures/IMG_8768.JPG

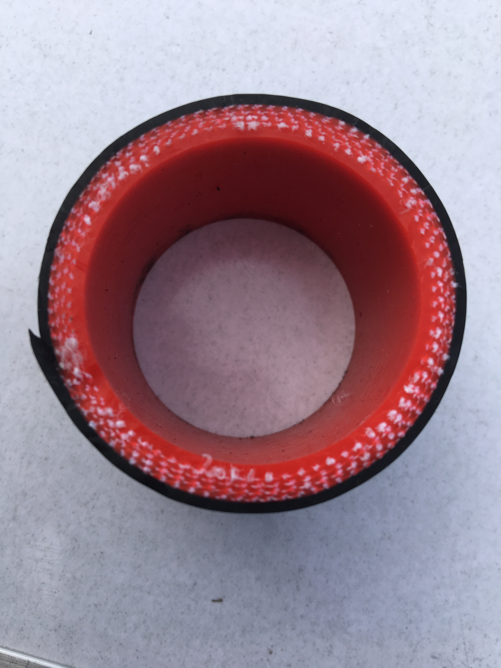
pictures/IMG_8768.JPG
