iafilius/CarElectricalRadiatorFanController/pictures/IMG_8770.JPG

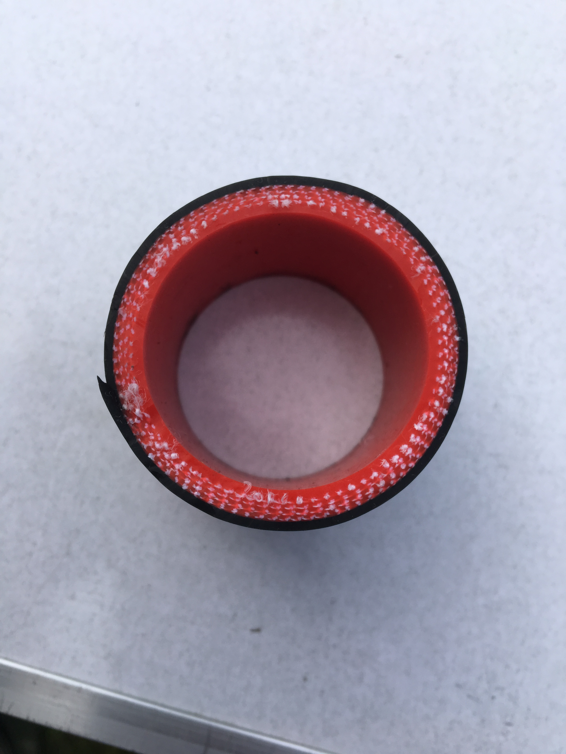
pictures/IMG_8770.JPG
