iafilius/CarElectricalRadiatorFanController/pictures/IMG_8781.JPG

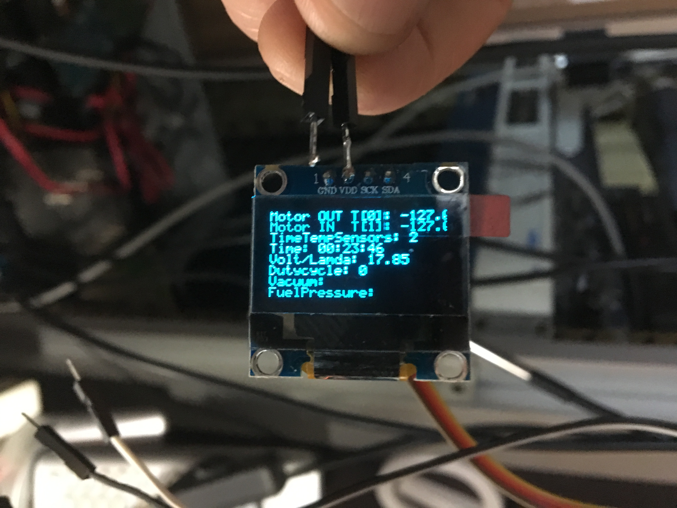
pictures/IMG_8781.JPG
