iafilius/CarElectricalRadiatorFanController/pictures/IMG_8782.JPG

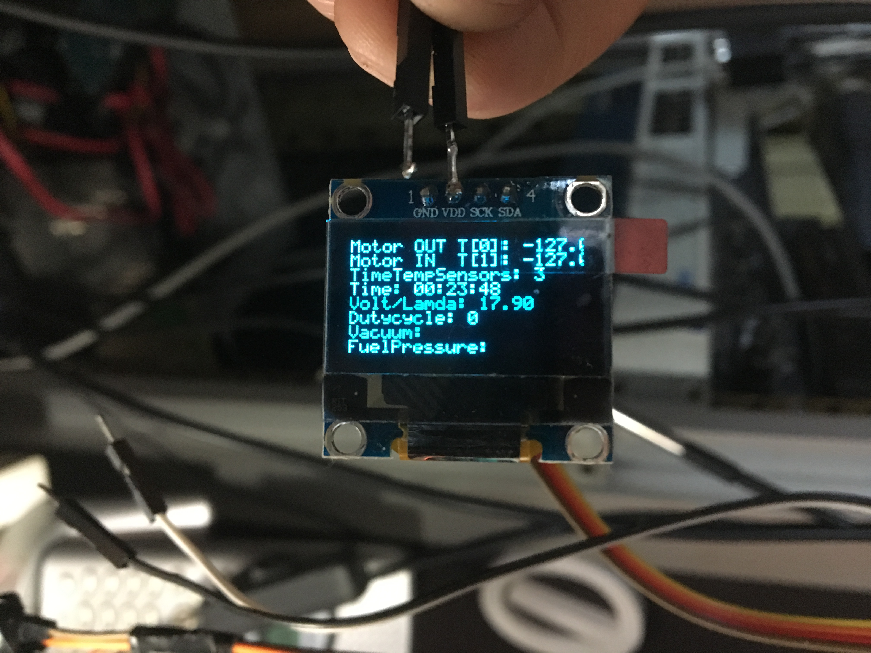
pictures/IMG_8782.JPG
