iafilius/CarElectricalRadiatorFanController/pictures/IMG_9138.JPG

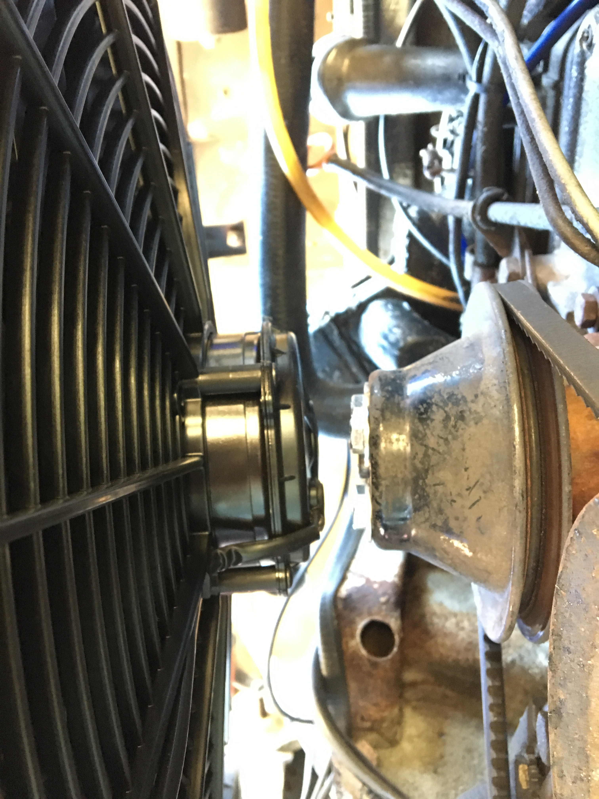
pictures/IMG_9138.JPG
