iafilius/CarElectricalRadiatorFanController/pictures/IMG_9139.JPG

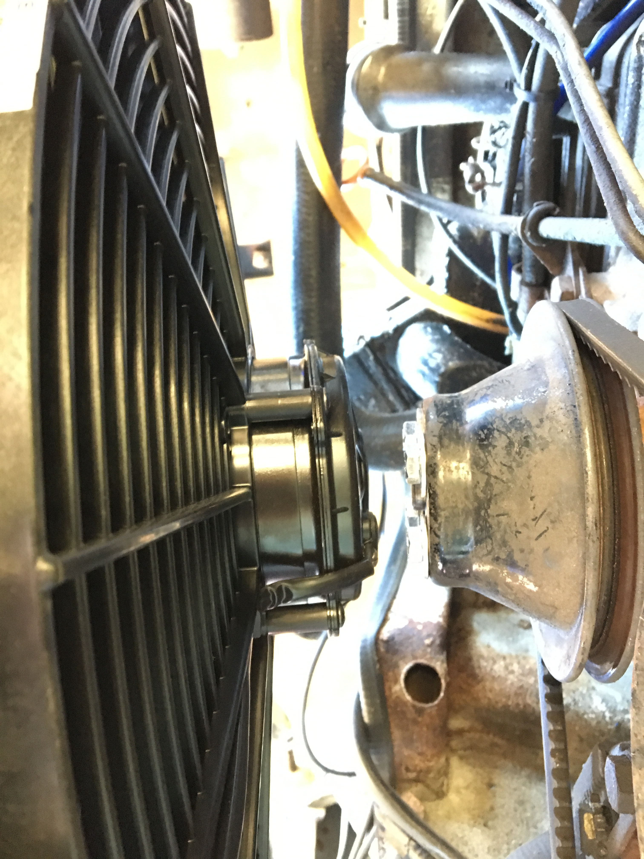
pictures/IMG_9139.JPG
