iafilius/CarElectricalRadiatorFanController/pictures/IMG_9140.JPG

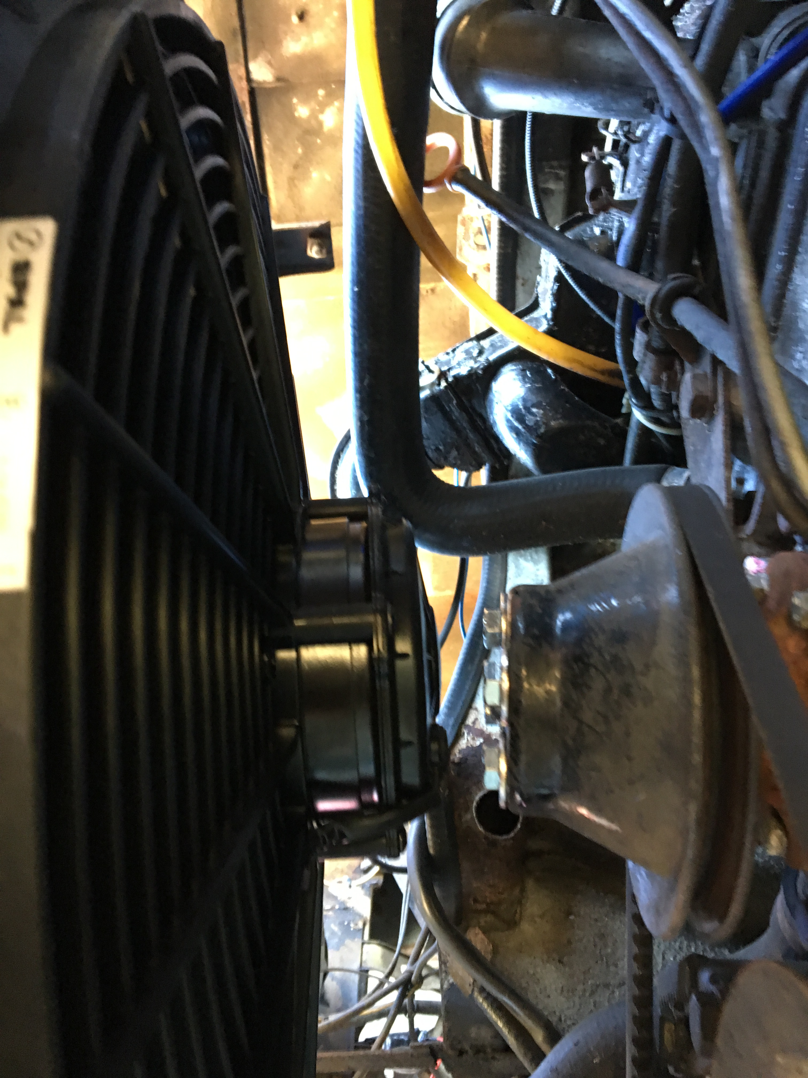
pictures/IMG_9140.JPG
