iafilius/CarElectricalRadiatorFanController/pictures/IMG_9141.JPG

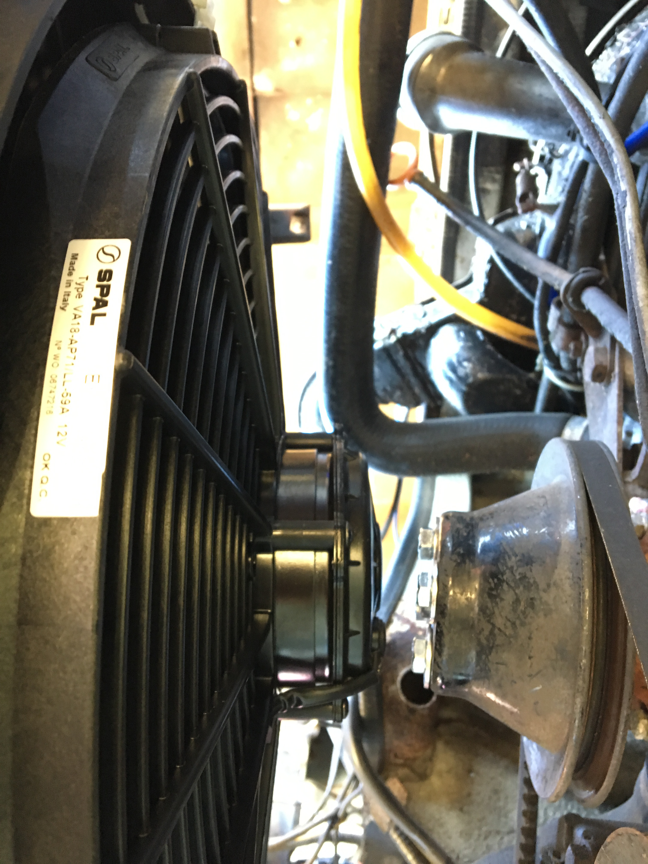
pictures/IMG_9141.JPG
