iafilius/CarElectricalRadiatorFanController/pictures/IMG_9143.JPG

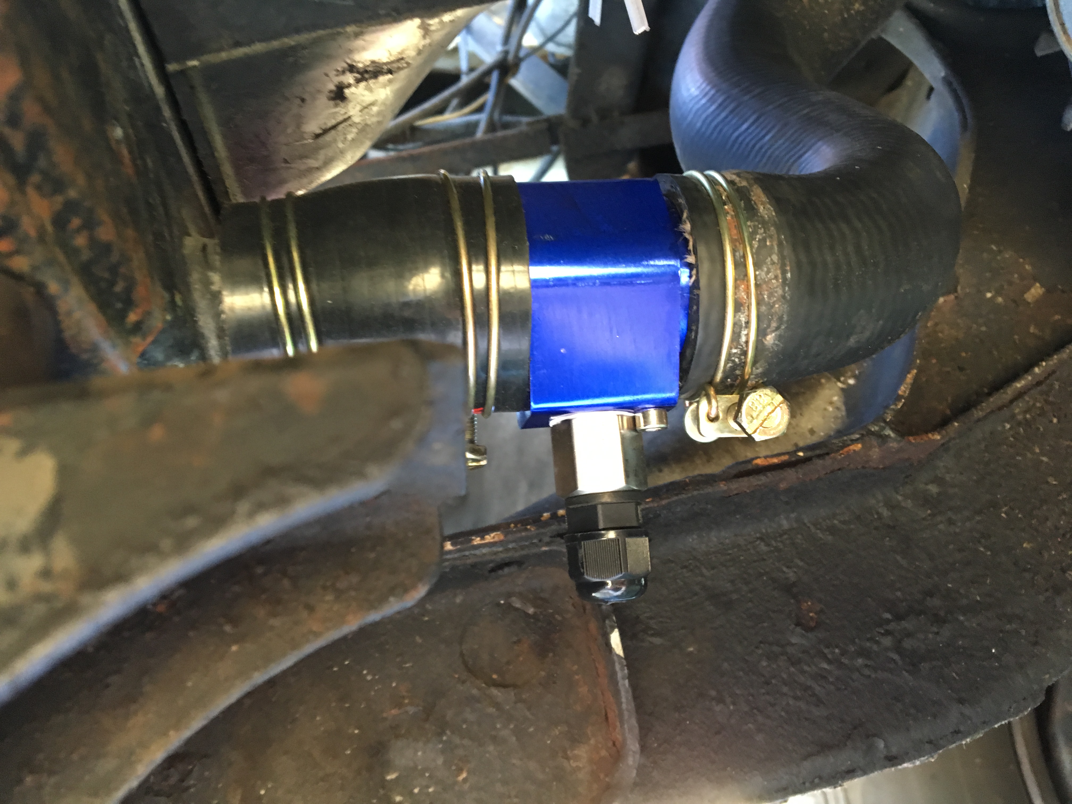
pictures/IMG_9143.JPG
