iafilius/CarElectricalRadiatorFanController/pictures/IMG_9205.PNG

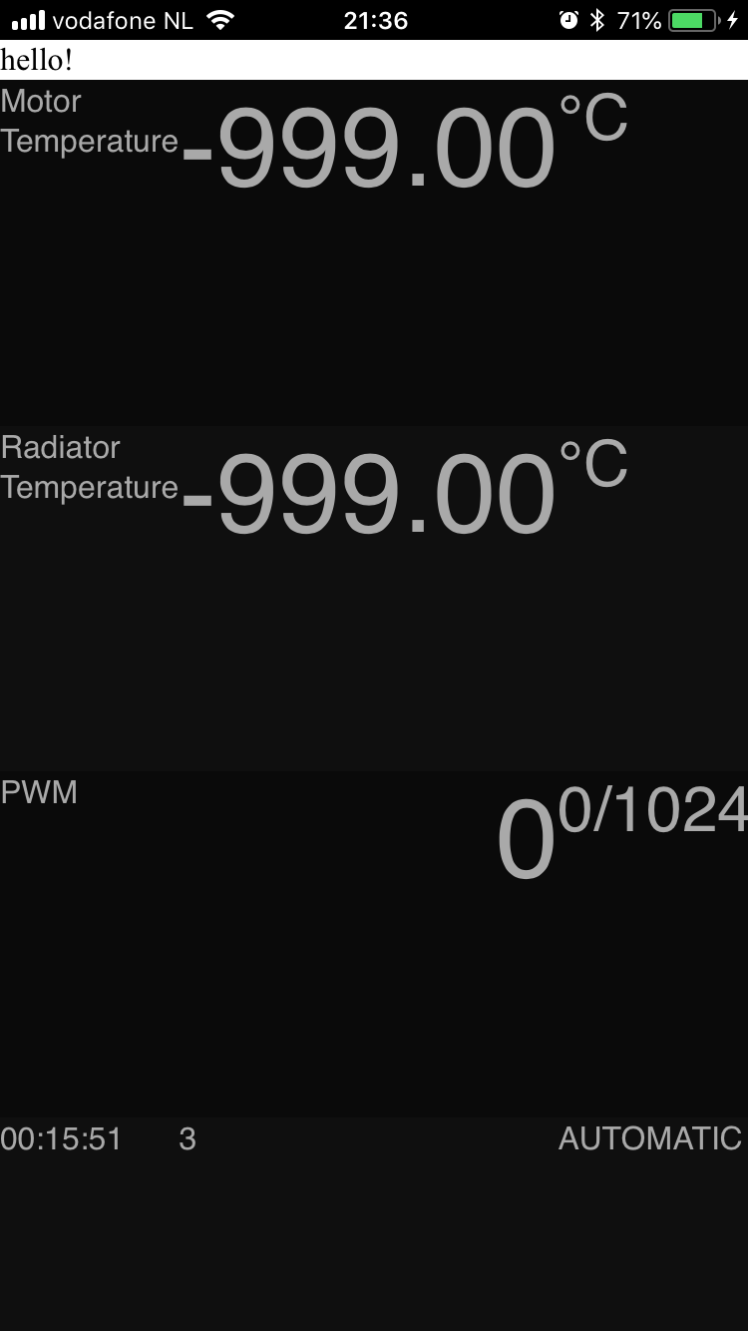
pictures/IMG_9205.PNG
