iafilius/CarElectricalRadiatorFanController/pictures/IMG_9206.PNG

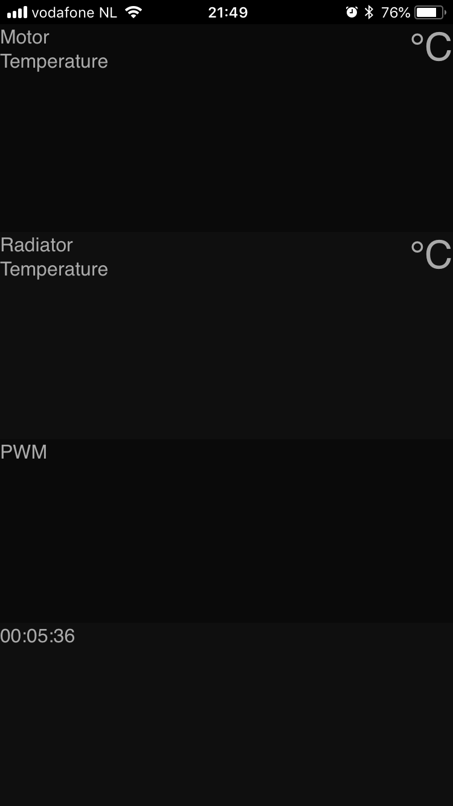
pictures/IMG_9206.PNG
