iafilius/CarElectricalRadiatorFanController/pictures/IMG_9211.JPG

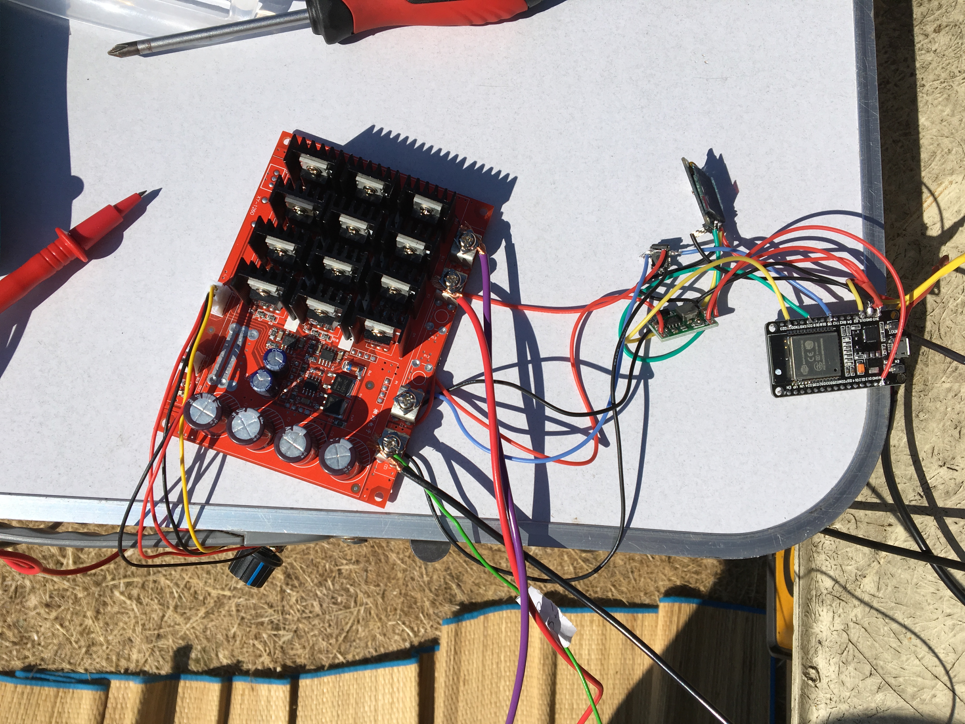
pictures/IMG_9211.JPG
