iafilius/CarElectricalRadiatorFanController/pictures/IMG_9212.JPG

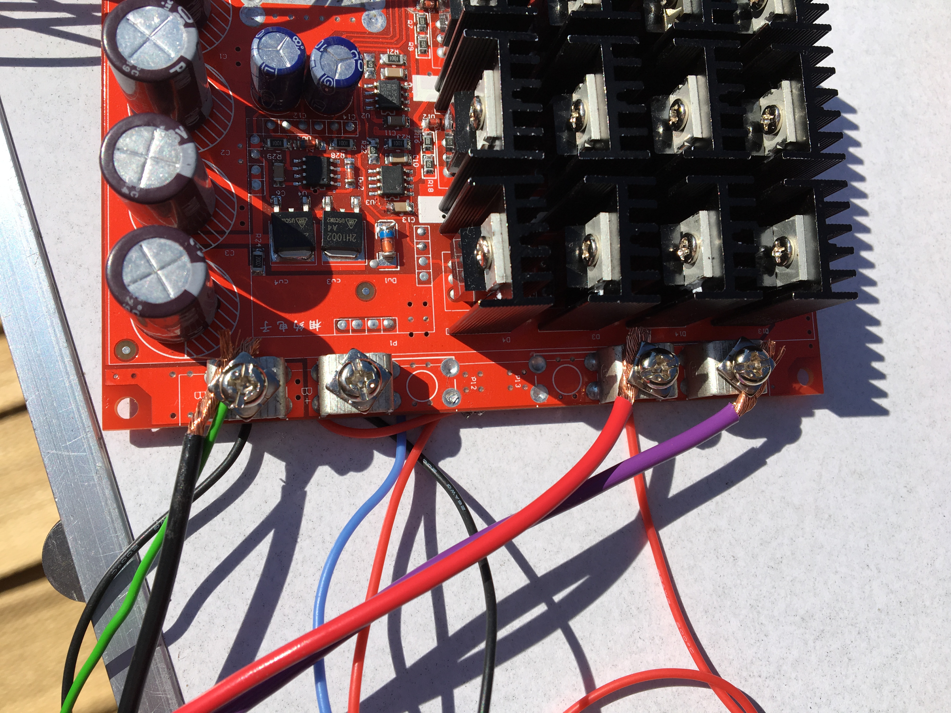
pictures/IMG_9212.JPG
