iafilius/CarElectricalRadiatorFanController/pictures/IMG_9247.PNG

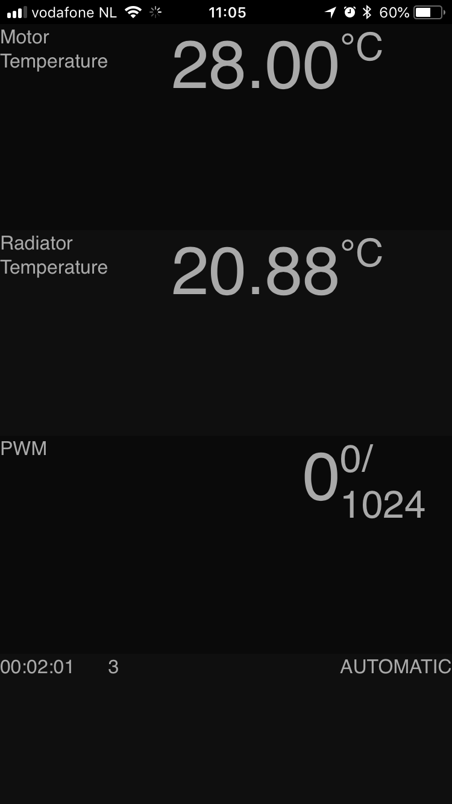
pictures/IMG_9247.PNG
