iafilius/CarElectricalRadiatorFanController/pictures/IMG_9249.PNG

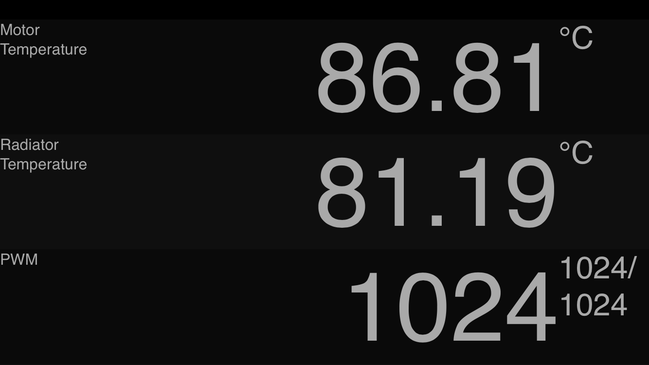
pictures/IMG_9249.PNG
