iafilius/CarElectricalRadiatorFanController/pictures/IMG_9250.PNG

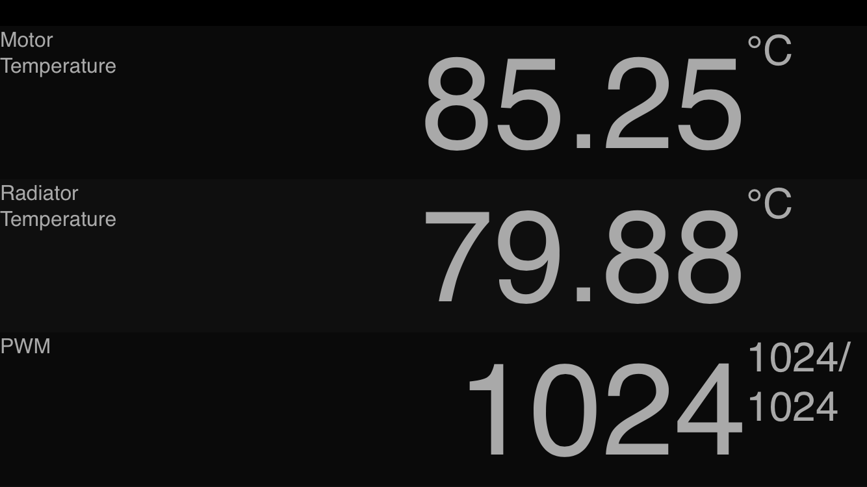
pictures/IMG_9250.PNG
