iafilius/CarElectricalRadiatorFanController/pictures/IMG_9264.PNG

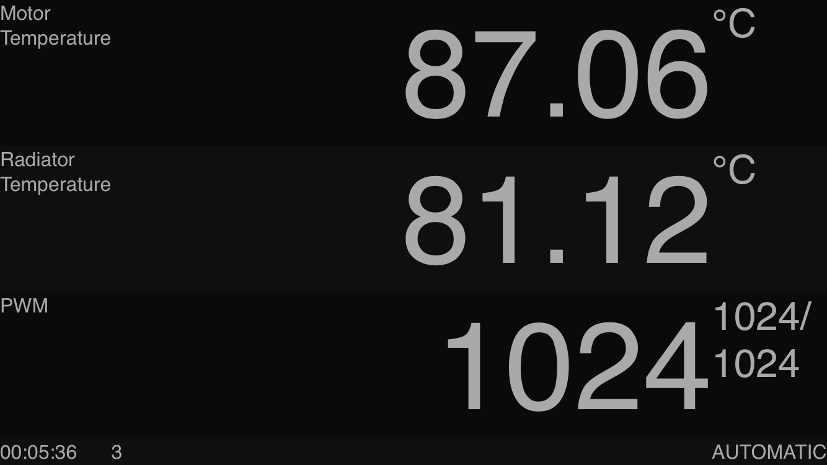
pictures/IMG_9264.PNG
