iafilius/CarElectricalRadiatorFanController/pictures/IMG_9266.PNG

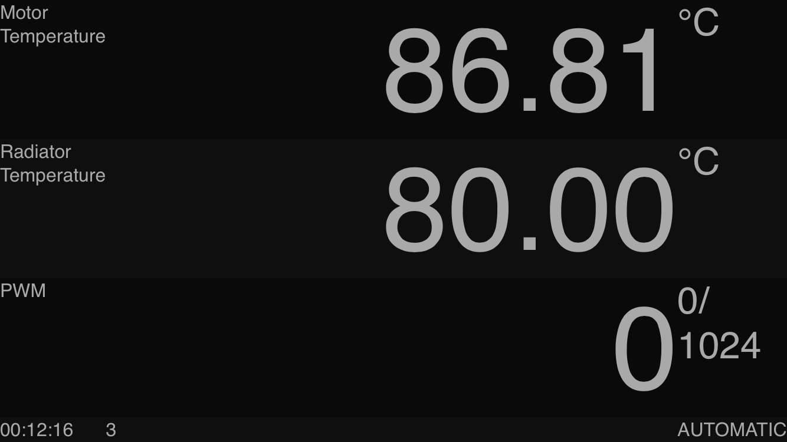
pictures/IMG_9266.PNG
