iafilius/CarElectricalRadiatorFanController/pictures/IMG_9269.PNG

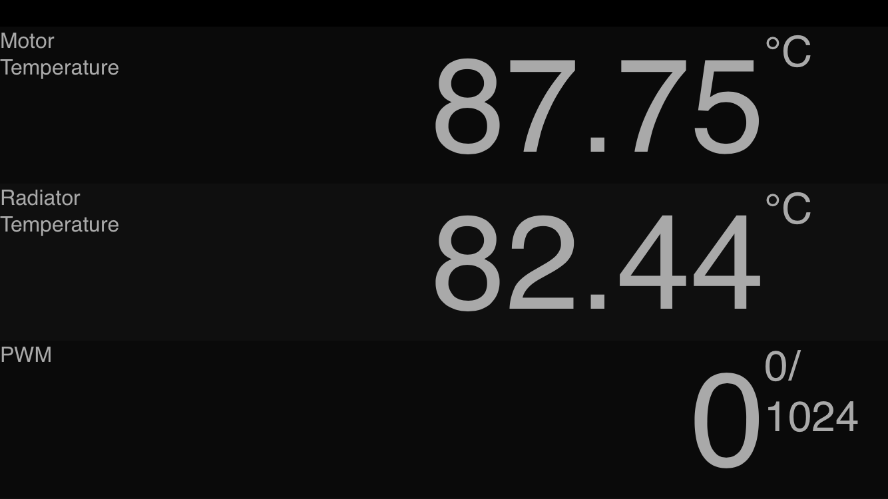
pictures/IMG_9269.PNG
