iafilius/CarElectricalRadiatorFanController/pictures/IMG_9270.PNG

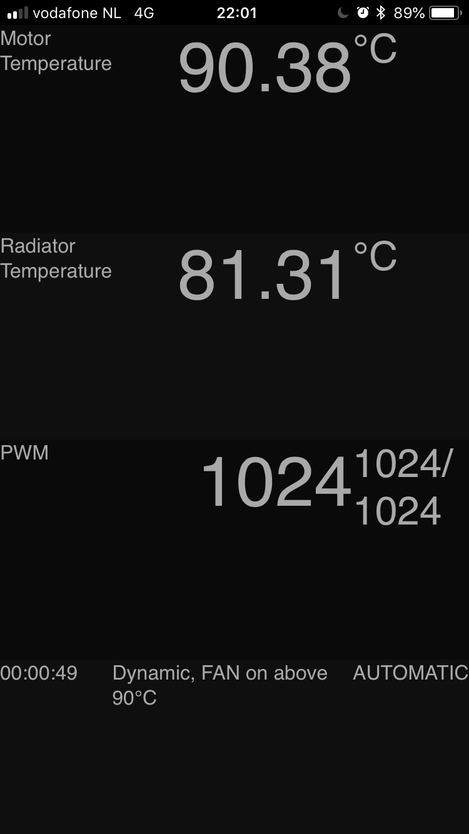
pictures/IMG_9270.PNG
