iafilius/CarElectricalRadiatorFanController/pictures/IMG_9275 - Copy.PNG

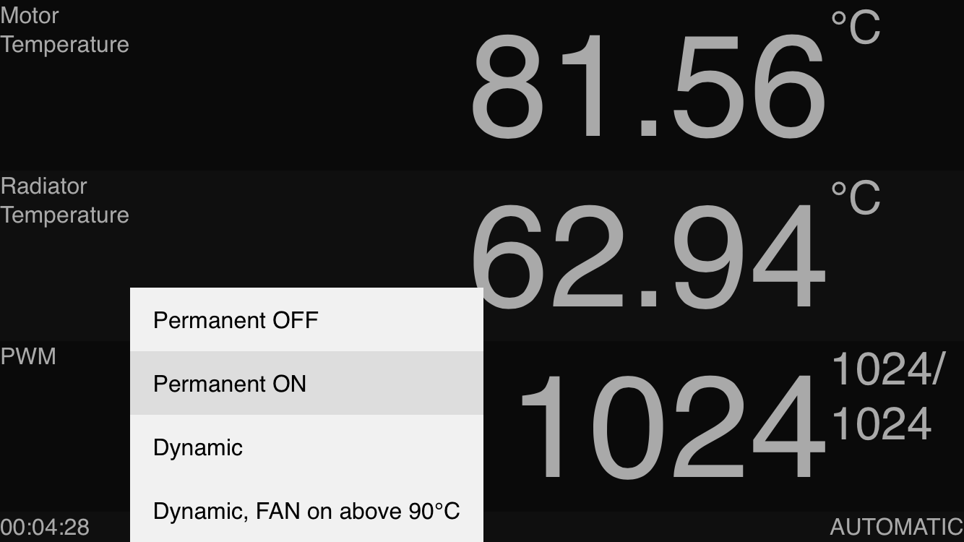
pictures/IMG_9275 - Copy.PNG
