iafilius/CarElectricalRadiatorFanController/pictures/IMG_9276.PNG

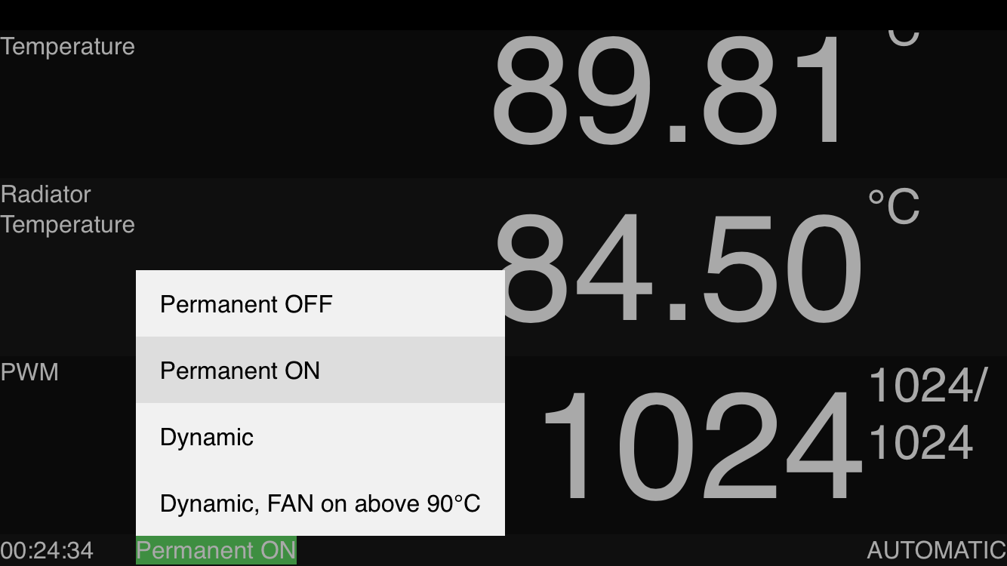
pictures/IMG_9276.PNG
