iafilius/CarElectricalRadiatorFanController/pictures/IMG_9282.PNG

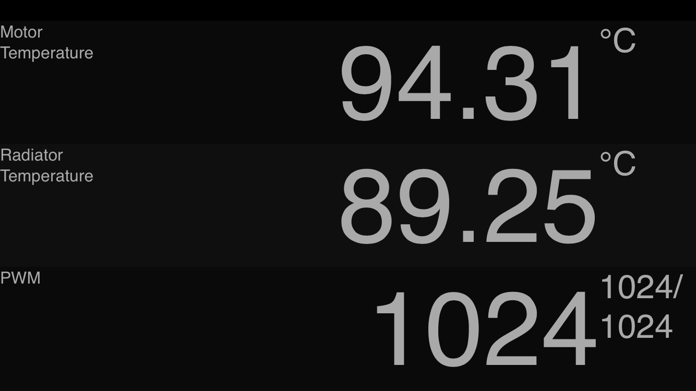
pictures/IMG_9282.PNG
