iafilius/CarElectricalRadiatorFanController/pictures/IMG_9463.PNG

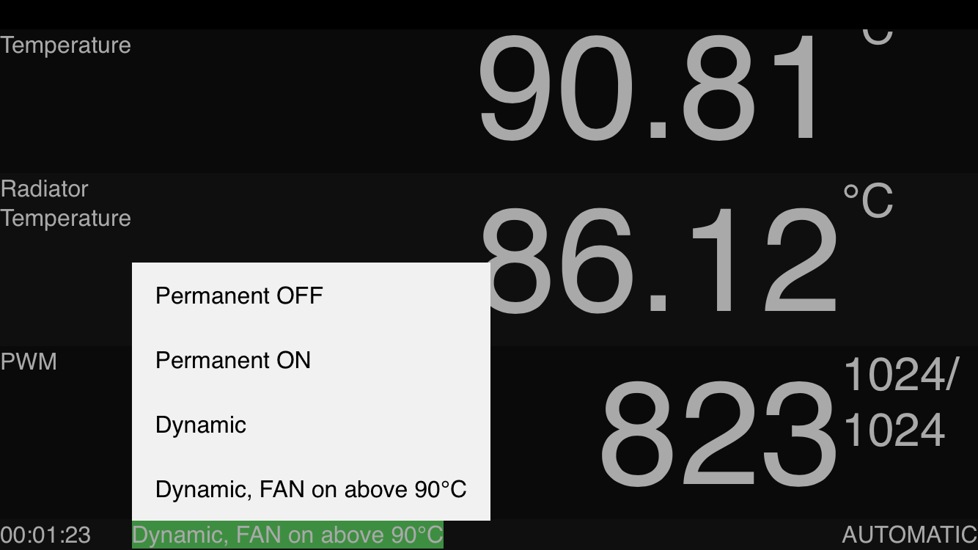
pictures/IMG_9463.PNG
