iafilius/CarElectricalRadiatorFanController/pictures/IMG_9466.PNG

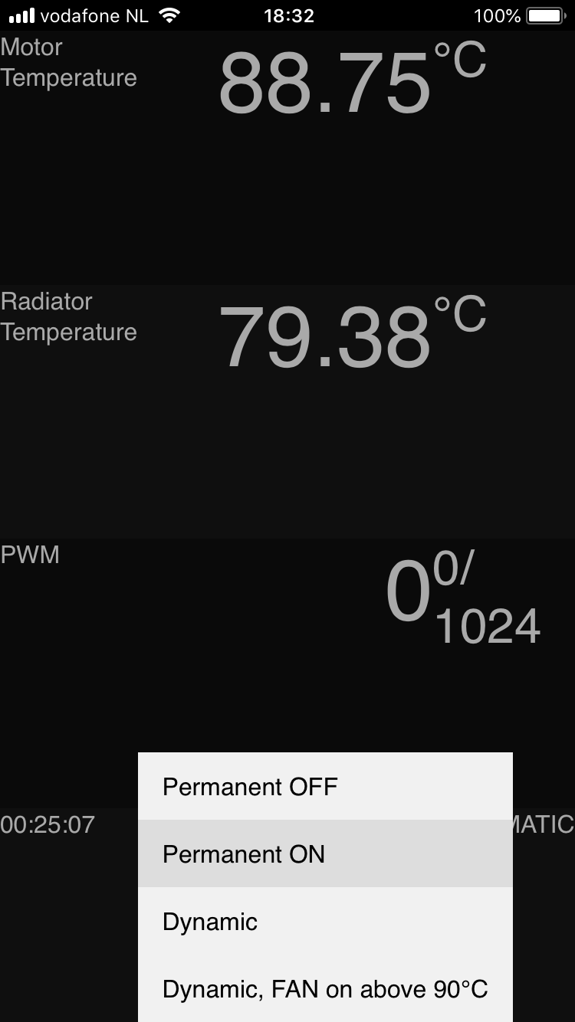
pictures/IMG_9466.PNG
