iafilius/CarElectricalRadiatorFanController/(commit log)

2018-08-23 First public version, fully operational, road tested, but possible full of bugs
    [CarElectricalRadiatorFanController.ino, NonVolatileStorage.ino, async_http_server.ino, ble.ino, cooling_policies.ino, display.ino, hwrevision.ino, pwm.ino]
2018-08-23 Added lots of component and action photo's replacing mechanical fan by electrical
2018-08-23 made a workaround visable to prevent rashes with define of STRING_PLUS_IS_ALLOC_BUG_WORKAROUND, exported binary as well
    [CarElectricalRadiatorFanController.ino, async_http_server.ino]
