iafilius/CarElectricalRadiatorFanController/pictures/IMG_8740.JPG

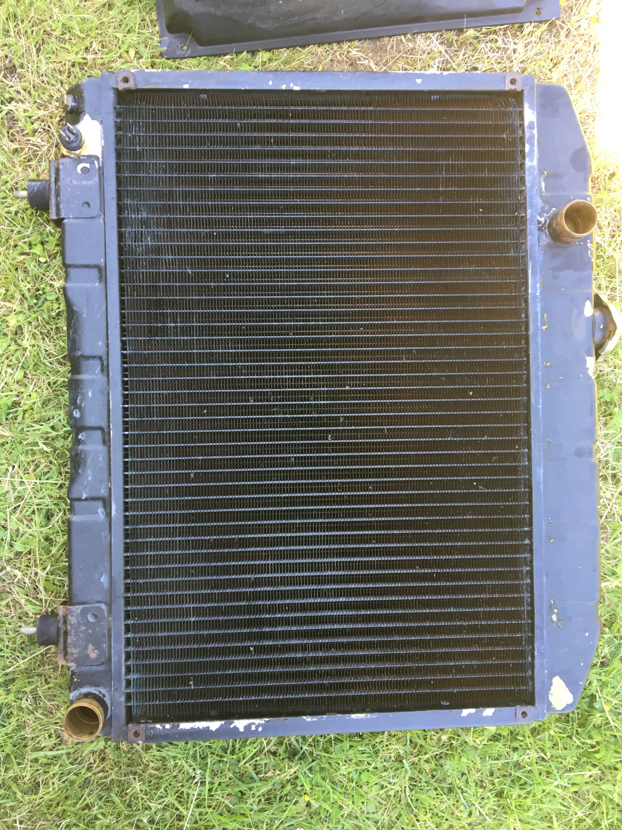
pictures/IMG_8740.JPG
