iafilius/CarElectricalRadiatorFanController/pictures/IMG_8745.JPG

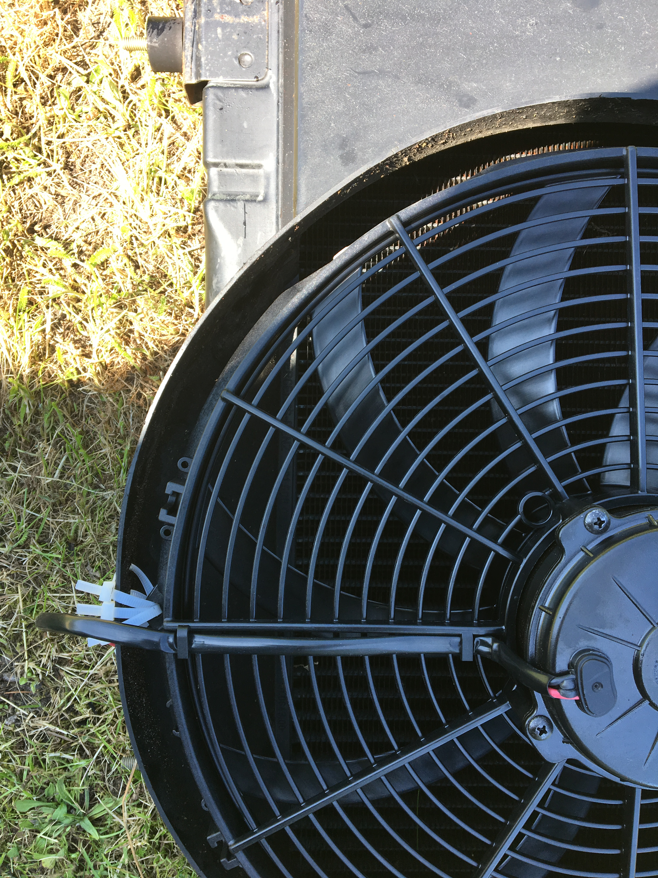
pictures/IMG_8745.JPG
