iafilius/CarElectricalRadiatorFanController/pictures/IMG_8747.JPG

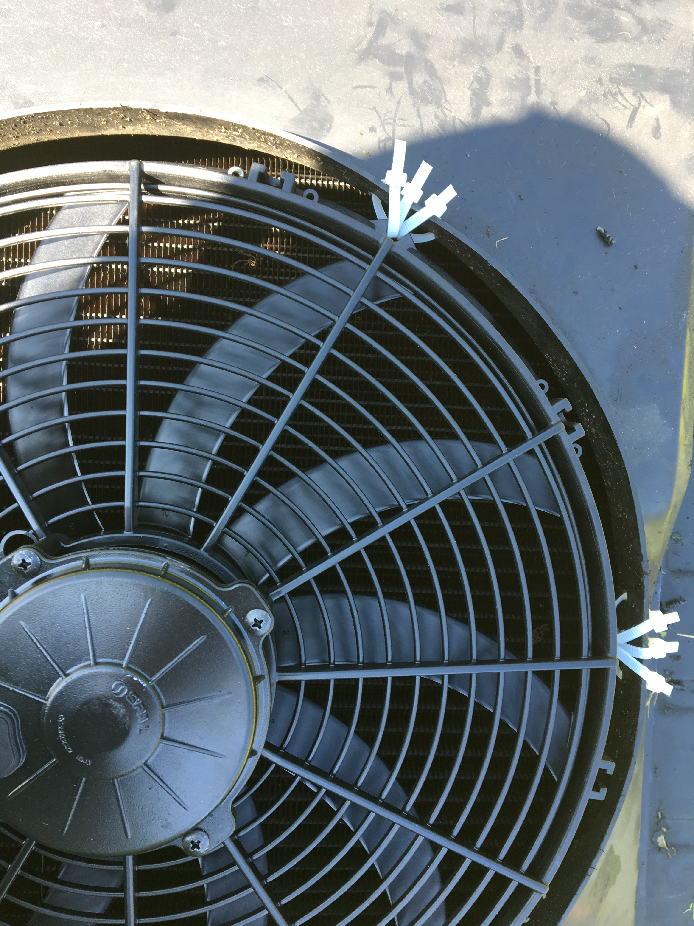
pictures/IMG_8747.JPG
