iafilius/CarElectricalRadiatorFanController/pictures/IMG_8748.JPG

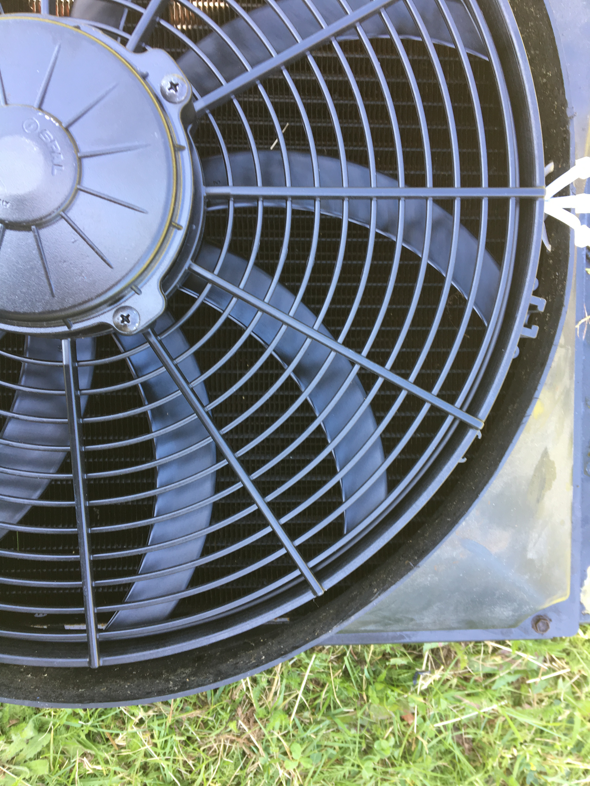
pictures/IMG_8748.JPG
