iafilius/CarElectricalRadiatorFanController/pictures/IMG_8749.JPG

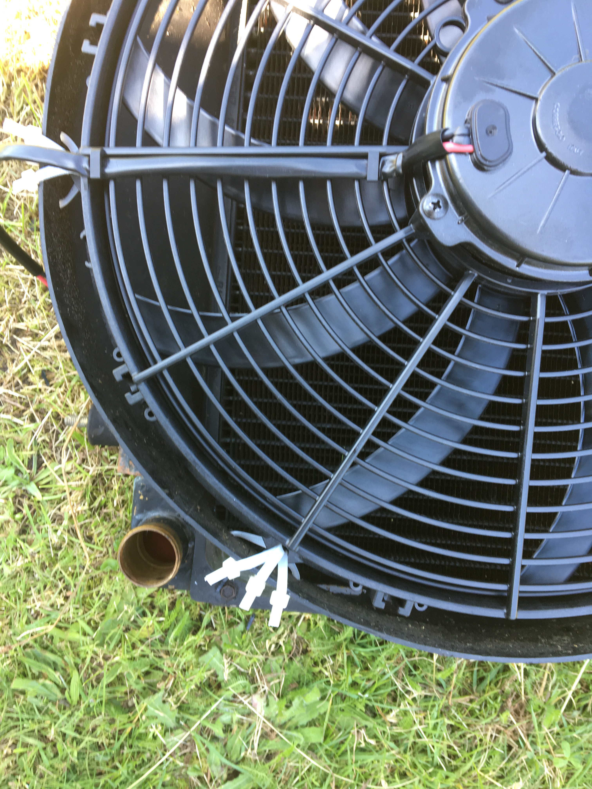
pictures/IMG_8749.JPG
