iafilius/CarElectricalRadiatorFanController/pictures/IMG_5720.JPG

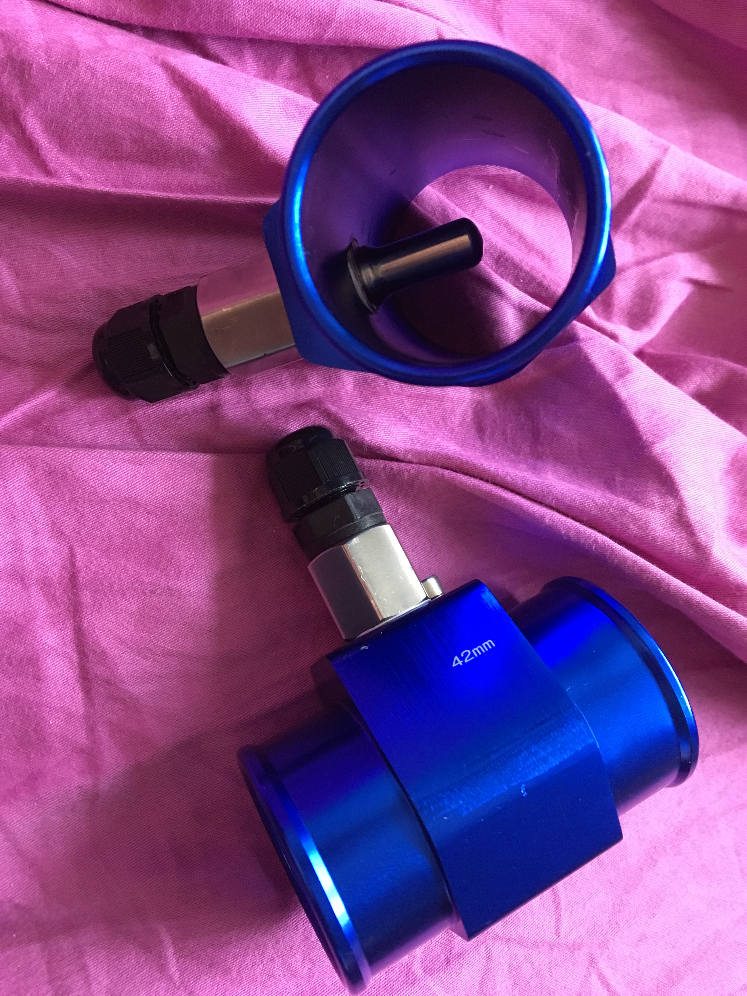
[picture p12: pictures/IMG_5720.JPG]
pictures/IMG_5720.JPG
